e-licktronic/Nava-v1.0/Eagle/Nava_v1.02.brd

## EAGLE design Eagle/Nava_v1.02.brd (2022-08-23)

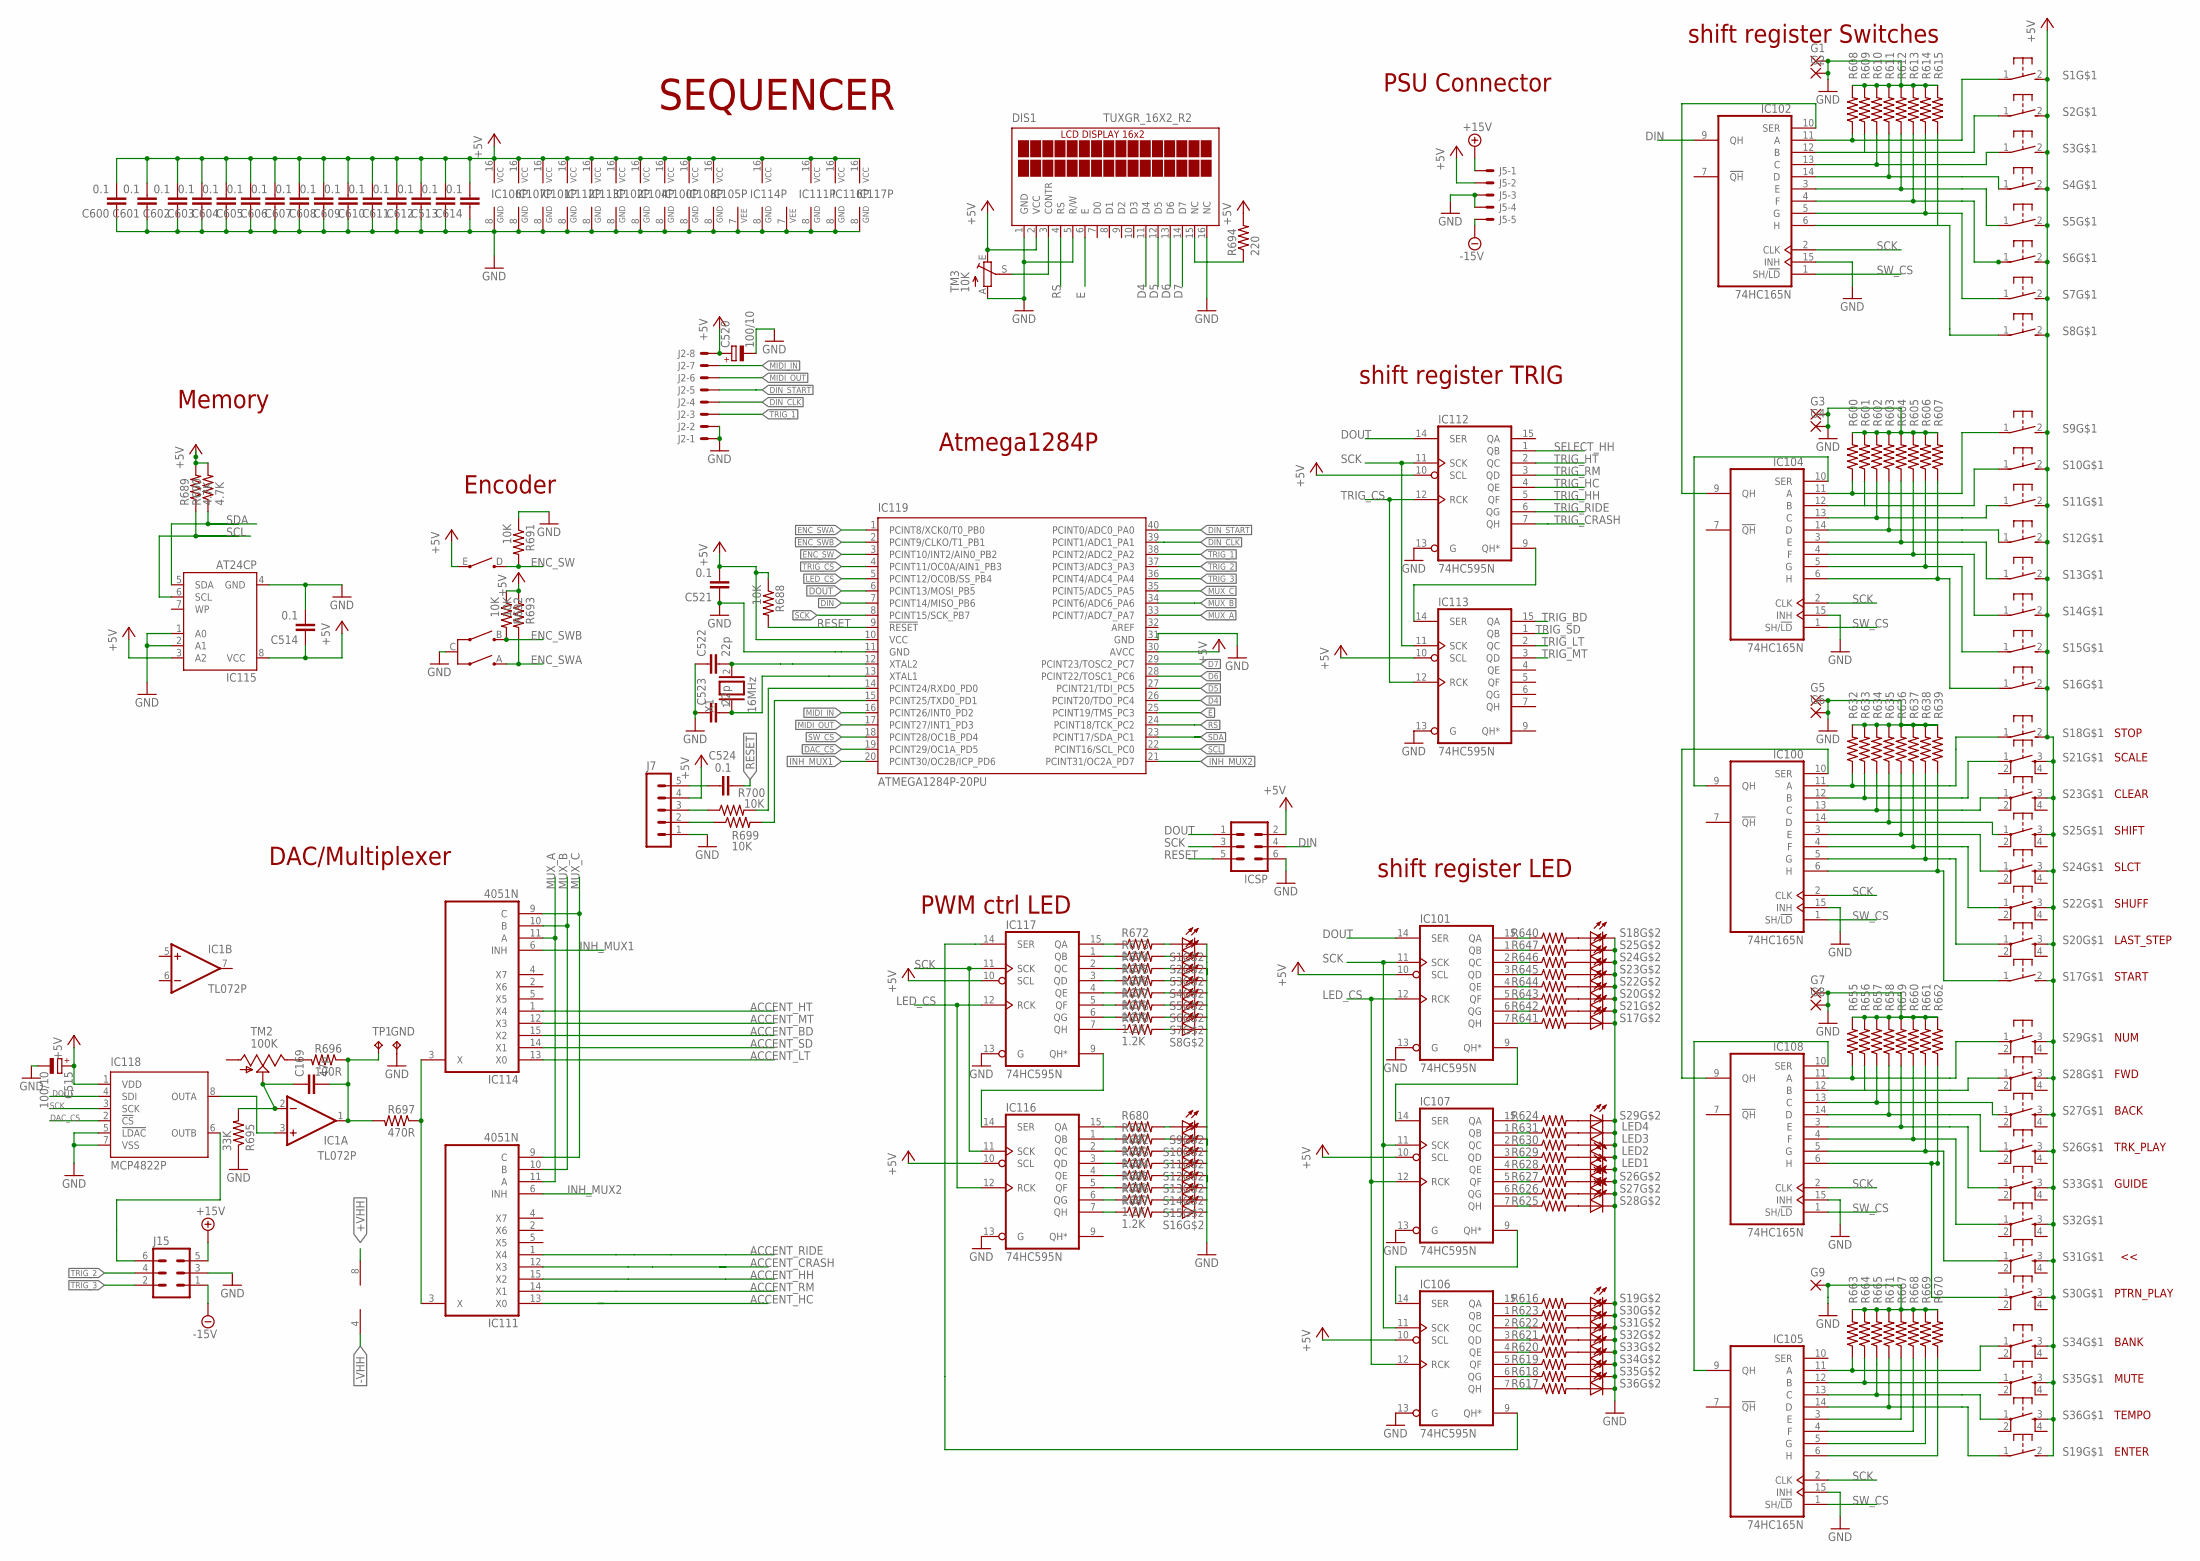
[picture p1: schematic Nava_v1.02.sch, sheet 1, SEQ]

Parts:
C169: 47p; C025-025X050
C513, C514, C521, C524, C600, C601, C602, C603, C604, C605, C606, C607, C608, C609, C610, C611, C612, C614: 0.1; C050-024X044
C515, C520: 100/10; E2-5
C522, C523: 22p; C025-025X050
DIS1: TUXGR_16X2_R2
G1, G2, G3, G4, G5, G6, G7, G8, G9: WIREPAD1,6/0,8; 1,6/0,8
GND: TPPAD1-13; P1-13
IC1: TL072P; DIL08
IC100, IC102, IC104, IC105, IC108: 74HC165N; DIL16
IC101, IC106, IC107, IC112, IC113, IC116, IC117: 74HC595N; DIL16
IC111, IC114: 4051N; DIL16
IC115: AT24CP; DIL08
IC118: MCP4822P; DIL8
IC119: ATMEGA1284P-20PU; DIL40
ICSP: MA03-2
J2: 22-27-2081-08; 6410-08
J5: KK-156-5
J7: MA05-1; MA05-1A
J15: MA03-2
LED1, LED2, LED3, LED4: LED3MM
R600, R601, R602, R603, R604, R605, R606, R607, R608, R609, R610, R611, R612, R613, R614, R615, R632, R633, R634, R635, R636, R637, R638, R639, R655, R656, R657, R658, R659, R660, R661, R662, R663, R664, R665, R667, R668, R669, R670, R671, R688, R691, R692, R693, R699, R700: 10K; 0207/7
R616, R617, R618, R619, R620, R621, R622, R623, R624, R625, R626, R627, R628, R629, R630, R631, R640, R641, R642, R643, R644, R645, R646, R647, R672, R673, R674, R675, R676, R677, R678, R679, R680, R681, R682, R683, R684, R685, R686, R687: 1.2K; 0207/7
R689, R690: 4.7K; 0207/7
R694: 220; 0207/7
R695: 33K; 0207/7
R696: 100R; 0207/7
R697: 470R; 0207/7
S1, S2, S3, S4, S5, S6, S7, S8, S9, S10, S11, S12, S13, S14, S15, S16, S17, S18, S19: MX1A_CHERRY_SW_LED"; MX1A-SW
S20, S21, S22, S23, S24, S25, S26, S27, S28, S29, S30, S31, S32, S33, S34, S35, S36: ZTSN_SW_LED"; SPH_SW
TM2: 100K; S64W
TM3: 10K; B25P
TP1: TPPAD1-13; P1-13
VR29: PEC16_ENCODER
X1: 16MHz; QS

Connections:
+5V: C513.2, C514.1, C515.+, C520.+, C521.2, C600.2, C601.2, C602.2, C603.2, C604.2, C605.2, C606.2, C607.2, C608.2, C609.2, C610.2, C611.2, C612.2, C614.2, DIS1.2 (VCC), IC100.16 (VCC), IC101.10 (SCL), IC101.16 (VCC), IC102.16 (VCC), IC104.16 (VCC), IC105.16 (VCC), IC106.10 (SCL), IC106.16 (VCC), IC107.10 (SCL), IC107.16 (VCC), IC108.16 (VCC), IC111.16 (VCC), IC112.10 (SCL), IC112.16 (VCC), IC113.10 (SCL), IC113.16 (VCC), IC114.16 (VCC), IC115.3 (A2), IC115.8 (VCC), IC116.10 (SCL), IC116.16 (VCC), IC117.10 (SCL), IC117.16 (VCC), IC118.1 (VDD), IC119.10 (VCC), IC119.30 (AVCC), ICSP.2, J2.8, J5.2, J7.4, R688.1, R689.2, R690.2, R692.1, R693.1, R694.2, S1.2 (S), S2.2 (S), S3.2 (S), S4.2 (S), S5.2 (S), S6.2 (S), S7.2 (S), S8.2 (S), S9.2 (S), S10.2 (S), S11.2 (S), S12.2 (S), S13.2 (S), S14.2 (S), S15.2 (S), S16.2 (S), S17.2 (S), S18.2 (S), S19.2 (S), S20.3 (S), S22.3 (S), S23.3 (S), S24.3 (S), S25.3 (S), S26.3 (S), S27.3 (S), S28.3 (S), S29.3 (S), S30.3 (S), S31.3 (S), S32.3 (S), S33.3 (S), S34.3 (S), S35.3 (S), S36.3 (S), TM3.E, VR29.E; also elsewhere on the board
+15V: J5.1, J15.5; also elsewhere on the board
+VHH: IC1.8 (V+); also elsewhere on the board
-15V: J5.5, J15.1; also elsewhere on the board
-VHH: IC1.4 (V-); also elsewhere on the board
ACCENT_BD: IC114.15 (X2); also elsewhere on the board
ACCENT_CRASH: IC111.12 (X3); also elsewhere on the board
ACCENT_HC: IC111.13 (X0); also elsewhere on the board
ACCENT_HH: IC111.15 (X2); also elsewhere on the board
ACCENT_HT: IC114.1 (X4); also elsewhere on the board
ACCENT_LT: IC114.13 (X0); also elsewhere on the board
ACCENT_MT: IC114.12 (X3); also elsewhere on the board
ACCENT_RIDE: IC111.1 (X4); also elsewhere on the board
ACCENT_RM: IC111.14 (X1); also elsewhere on the board
ACCENT_SD: IC114.14 (X1); also elsewhere on the board
D4: DIS1.11 (D4), IC119.26 (PCINT20/TDO_PC4)
D5: DIS1.12 (D5), IC119.27 (PCINT21/TDI_PC5)
D6: DIS1.13 (D6), IC119.28 (PCINT22/TOSC1_PC6)
D7: DIS1.14 (D7), IC119.29 (PCINT23/TOSC2_PC7)
DAC_CS: IC118.2 (!CS!), IC119.19 (PCINT29/OC1A_PD5)
DIN: IC102.9 (QH), IC119.7 (PCINT14/MISO_PB6), ICSP.4
DIN_CLK: IC119.39 (PCINT1/ADC1_PA1), J2.4
DIN_START: IC119.40 (PCINT0/ADC0_PA0), J2.5
DOUT: IC101.14 (SER), IC112.14 (SER), IC118.4 (SDI), IC119.6 (PCINT13/MOSI_PB5), ICSP.1
E: DIS1.6 (E), IC119.25 (PCINT19/TMS_PC3)
ENC_SW: IC119.3 (PCINT10/INT2/AIN0_PB2), R691.2, VR29.D
ENC_SWA: IC119.1 (PCINT8/XCK0/T0_PB0), R693.2, VR29.A
ENC_SWB: IC119.2 (PCINT9/CLKO/T1_PB1), R692.2, VR29.B
GND: C513.1, C514.2, C515.-, C520.-, C521.1, C522.1, C523.1, C600.1, C601.1, C602.1, C603.1, C604.1, C605.1, C606.1, C607.1, C608.1, C609.1, C610.1, C611.1, C612.1, C614.1, DIS1.1 (GND), DIS1.5 (R/W), DIS1.16 (NC), G1.1, G2.1, G3.1, G4.1, G5.1, G6.1, G7.1, G8.1, G9.1, GND.TP, IC100.8 (GND), IC100.15 (INH), IC101.8 (GND), IC101.13 (G), IC102.8 (GND), IC102.15 (INH), IC104.8 (GND), IC104.15 (INH), IC105.8 (GND), IC105.15 (INH), IC106.8 (GND), IC106.13 (G), IC107.8 (GND), IC107.13 (G), IC108.8 (GND), IC108.15 (INH), IC111.7 (VEE), IC111.8 (GND), IC112.8 (GND), IC112.13 (G), IC113.8 (GND), IC113.13 (G), IC114.7 (VEE), IC114.8 (GND), IC115.1 (A0), IC115.2 (A1), IC115.4 (GND), IC116.8 (GND), IC116.13 (G), IC117.8 (GND), IC117.13 (G), IC118.5 (!LDAC!), IC118.7 (VSS), IC119.11 (GND), IC119.31 (GND), ICSP.6, J2.1, J2.2, J5.3, J5.4, J7.1, J15.3, LED1.K (C), LED2.K (C), LED3.K (C), LED4.K (C), R600.2, R601.2, R602.2, R603.2, R604.2, R605.2, R606.2, R607.2, R608.2, R609.2, R610.2, R611.2, R612.2, R613.2, R614.2, R615.2, R632.2, R633.2, R634.2, R635.2, R636.2, R637.2, R638.2, R639.2, R655.2, R656.2, R657.2, R658.2, R659.2, R660.2, R661.2, R662.2, R663.2, R664.2, R665.2, R667.2, R668.2, R669.2, R670.2, R671.2, R691.1, R695.1, S1.K (C), S2.K (C), S3.K (C), S4.K (C), S5.K (C), S6.K (C), S7.K (C), S8.K (C), S9.K (C), S10.K (C), S11.K (C), S12.K (C), S13.K (C), S14.K (C), S15.K (C), S16.K (C), S17.K (C), S18.K (C), S19.K (C), S20.K (C), S21.K (C), S22.K (C), S23.K (C), S24.K (C), S25.K (C), S26.K (C), S27.K (C), S28.K (C), S29.K (C), S30.K (C), S31.K (C), S32.K (C), S33.K (C), S34.K (C), S35.K (C), S36.K (C), TM3.A, VR29.C; also elsewhere on the board
INH_MUX1: IC114.6 (INH), IC119.20 (PCINT30/OC2B/ICP_PD6)
INH_MUX2: IC111.6 (INH), IC119.21 (PCINT31/OC2A_PD7)
LED_CS: IC101.12 (RCK), IC106.12 (RCK), IC107.12 (RCK), IC116.12 (RCK), IC117.12 (RCK), IC119.5 (PCINT12/OC0B/SS_PB4)
MIDI_IN: IC119.16 (PCINT26/INT0_PD2), J2.7
MIDI_OUT: IC119.17 (PCINT27/INT1_PD3), J2.6
MUX_A: IC111.11 (A), IC114.11 (A), IC119.33 (PCINT7/ADC7_PA7)
MUX_B: IC111.10 (B), IC114.10 (B), IC119.34 (PCINT6/ADC6_PA6)
MUX_C: IC111.9 (C), IC114.9 (C), IC119.35 (PCINT5/ADC5_PA5)
unnamed: R624.2, S29.A
unnamed: R625.2, S28.A
unnamed: R626.2, S27.A
unnamed: R627.2, S26.A
unnamed: R647.2, S25.A
unnamed: R646.2, S24.A
unnamed: R645.2, S23.A
unnamed: R644.2, S22.A
unnamed: R642.2, S21.A
unnamed: R643.2, S20.A
unnamed: R640.2, S18.A
unnamed: R641.2, S17.A
unnamed: LED4.A, R631.2
unnamed: LED3.A, R630.2
unnamed: LED2.A, R629.2
unnamed: LED1.A, R628.2
unnamed: R616.2, S19.A
unnamed: R617.2, S36.A
unnamed: R618.2, S35.A
unnamed: R619.2, S34.A
unnamed: R620.2, S33.A
unnamed: R621.2, S32.A
unnamed: R622.2, S31.A
unnamed: R623.2, S30.A
unnamed: IC108.14 (D), R658.1, S26.1
unnamed: IC1.3 (+IN), IC118.8 (OUTA)
unnamed: IC117.15 (QA), R672.1
unnamed: IC117.1 (QB), R673.1
unnamed: IC117.2 (QC), R674.1
unnamed: IC117.3 (QD), R675.1
unnamed: IC117.4 (QE), R676.1
unnamed: IC117.5 (QF), R677.1
unnamed: IC117.6 (QG), R678.1
unnamed: IC117.7 (QH), R679.1
unnamed: IC116.14 (SER), IC117.9 (QH*)
unnamed: IC116.15 (QA), R680.1
unnamed: IC116.1 (QB), R681.1
unnamed: IC116.2 (QC), R682.1
unnamed: IC116.3 (QD), R683.1
unnamed: IC116.4 (QE), R684.1
unnamed: IC116.5 (QF), R685.1
unnamed: IC116.6 (QG), R686.1
unnamed: IC116.7 (QH), R687.1
unnamed: R680.2, S9.A
unnamed: R681.2, S10.A
unnamed: R682.2, S11.A
unnamed: R683.2, S12.A
unnamed: R684.2, S13.A
unnamed: R685.2, S14.A
unnamed: R686.2, S15.A
unnamed: R687.2, S16.A
unnamed: R672.2, S1.A
unnamed: R673.2, S2.A
unnamed: R674.2, S3.A
unnamed: R675.2, S4.A
unnamed: R676.2, S5.A
unnamed: R677.2, S6.A
unnamed: R678.2, S7.A
unnamed: R679.2, S8.A
unnamed: IC106.9 (QH*), IC117.14 (SER)
unnamed: IC118.6 (OUTB), J15.6
unnamed: IC119.15 (PCINT25/TXD0_PD1), R699.2
unnamed: IC119.14 (PCINT24/RXD0_PD0), R700.2
unnamed: C522.2, IC119.12 (XTAL2), X1.2
unnamed: C523.2, IC119.13 (XTAL1), X1.1
unnamed: IC102.11 (A), R608.1, S1.1
unnamed: IC102.12 (B), R609.1, S2.1
unnamed: IC102.13 (C), R610.1, S3.1
unnamed: IC102.14 (D), R611.1, S4.1
unnamed: IC102.3 (E), R612.1, S5.1
unnamed: IC102.4 (F), R613.1, S6.1
unnamed: IC102.5 (G), R614.1, S7.1
unnamed: IC102.6 (H), R615.1, S8.1
unnamed: IC104.11 (A), R600.1, S9.1
unnamed: IC104.12 (B), R601.1, S10.1
unnamed: IC104.13 (C), R602.1, S11.1
unnamed: IC104.14 (D), R603.1, S12.1
unnamed: IC104.3 (E), R604.1, S13.1
unnamed: IC104.4 (F), R605.1, S14.1
unnamed: IC104.5 (G), R606.1, S15.1
unnamed: IC104.6 (H), R607.1, S16.1
unnamed: IC100.11 (A), R632.1, S18.1
unnamed: IC100.12 (B), R633.1, S21.1
unnamed: IC100.13 (C), R634.1, S23.1
unnamed: IC100.14 (D), R635.1, S25.1
unnamed: IC100.3 (E), R636.1, S24.1
unnamed: IC100.4 (F), R637.1, S22.1
unnamed: IC100.5 (G), R638.1, S20.1
unnamed: IC102.10 (SER), IC104.9 (QH)
unnamed: IC100.9 (QH), IC104.10 (SER)
unnamed: IC100.6 (H), R639.1, S17.1
unnamed: IC111.3 (X), IC114.3 (X), R697.1
unnamed: IC101.15 (QA), R640.1
unnamed: IC100.10 (SER), IC108.9 (QH)
unnamed: IC108.11 (A), R655.1, S29.1
unnamed: IC108.12 (B), R656.1, S28.1
unnamed: IC108.13 (C), R657.1, S27.1
unnamed: IC108.3 (E), R659.1, S33.1
unnamed: IC108.4 (F), R660.1, S32.1
unnamed: IC108.5 (G), R661.1, S31.1
unnamed: IC108.6 (H), R662.1, S30.1
unnamed: IC101.1 (QB), R647.1
unnamed: IC105.9 (QH), IC108.10 (SER)
unnamed: IC101.2 (QC), R646.1
unnamed: IC105.11 (A), R663.1, S34.1
unnamed: IC105.12 (B), R664.1, S35.1
unnamed: IC105.13 (C), R665.1, S36.1
unnamed: IC105.14 (D), R671.1, S19.1
unnamed: IC105.3 (E), R667.1
unnamed: IC105.4 (F), R668.1
unnamed: IC105.5 (G), R669.1
unnamed: IC105.6 (H), R670.1
unnamed: IC101.3 (QD), R645.1
unnamed: IC101.4 (QE), R644.1
unnamed: IC101.5 (QF), R643.1
unnamed: IC101.6 (QG), R642.1
unnamed: IC101.7 (QH), R641.1
unnamed: IC107.15 (QA), R624.1
unnamed: IC107.1 (QB), R631.1
unnamed: IC107.2 (QC), R630.1
unnamed: IC107.3 (QD), R629.1
unnamed: IC107.4 (QE), R628.1
unnamed: IC107.5 (QF), R627.1
unnamed: IC107.6 (QG), R626.1
unnamed: IC107.7 (QH), R625.1
unnamed: IC101.9 (QH*), IC107.14 (SER)
unnamed: IC106.14 (SER), IC107.9 (QH*)
unnamed: IC106.15 (QA), R616.1
unnamed: IC106.1 (QB), R623.1
unnamed: IC106.2 (QC), R622.1
unnamed: IC106.3 (QD), R621.1
unnamed: IC106.4 (QE), R620.1
unnamed: IC106.5 (QF), R619.1
unnamed: IC106.6 (QG), R618.1
unnamed: IC106.7 (QH), R617.1
unnamed: R696.2, TM2.E
unnamed: C169.2, IC1.1 (OUT), R696.1, R697.2, TP1.TP
unnamed: C169.1, IC1.2 (-IN), R695.2, TM2.S
unnamed: DIS1.15 (NC), R694.1
unnamed: DIS1.3 (CONTR), TM3.S
unnamed: IC112.9 (QH*), IC113.14 (SER)
unnamed: C524.2, J7.5
unnamed: J7.3, R700.1
unnamed: J7.2, R699.1
RESET: C524.1, IC119.9 (!RESET), ICSP.5, R688.2
RS: DIS1.4 (RS), IC119.24 (PCINT18/TCK_PC2)
SCK: IC100.2 (CLK), IC101.11 (SCK), IC102.2 (CLK), IC104.2 (CLK), IC105.2 (CLK), IC106.11 (SCK), IC107.11 (SCK), IC108.2 (CLK), IC112.11 (SCK), IC113.11 (SCK), IC116.11 (SCK), IC117.11 (SCK), IC118.3 (SCK), IC119.8 (PCINT15/SCK_PB7), ICSP.3
SCL: IC115.6 (SCL), IC119.22 (PCINT16/SCL_PC0), R689.1
SDA: IC115.5 (SDA), IC119.23 (PCINT17/SDA_PC1), R690.1
SELECT_HH: IC112.1 (QB); also elsewhere on the board
SW_CS: IC100.1 (SH/!LD), IC102.1 (SH/!LD), IC104.1 (SH/!LD), IC105.1 (SH/!LD), IC108.1 (SH/!LD), IC119.18 (PCINT28/OC1B_PD4)
TRIG_1: IC119.38 (PCINT2/ADC2_PA2), J2.3
TRIG_2: IC119.37 (PCINT3/ADC3_PA3), J15.4
TRIG_3: IC119.36 (PCINT4/ADC4_PA4), J15.2
TRIG_BD: IC113.15 (QA); also elsewhere on the board
TRIG_CRASH: IC112.7 (QH); also elsewhere on the board
TRIG_CS: IC112.12 (RCK), IC113.12 (RCK), IC119.4 (PCINT11/OC0A/AIN1_PB3)
TRIG_HC: IC112.4 (QE); also elsewhere on the board
TRIG_HH: IC112.5 (QF); also elsewhere on the board
TRIG_HT: IC112.2 (QC); also elsewhere on the board
TRIG_LT: IC113.2 (QC); also elsewhere on the board
TRIG_MT: IC113.3 (QD); also elsewhere on the board
TRIG_RIDE: IC112.6 (QG); also elsewhere on the board
TRIG_RM: IC112.3 (QD); also elsewhere on the board
TRIG_SD: IC113.1 (QB); also elsewhere on the board

Notes on the sheet:
Memory
Encoder
Atmega1284P
DAC/Multiplexer
PWM ctrl LED
shift register LED
shift register TRIG
shift register Switches
SEQUENCER
PSU Connector
STOP
SCALE
CLEAR
SHIFT
SLCT
SHUFF
LAST_STEP
START
NUM
FWD
BACK
TRK_PLAY
GUIDE
PTRN_PLAY
BANK
MUTE
TEMPO
ENTER

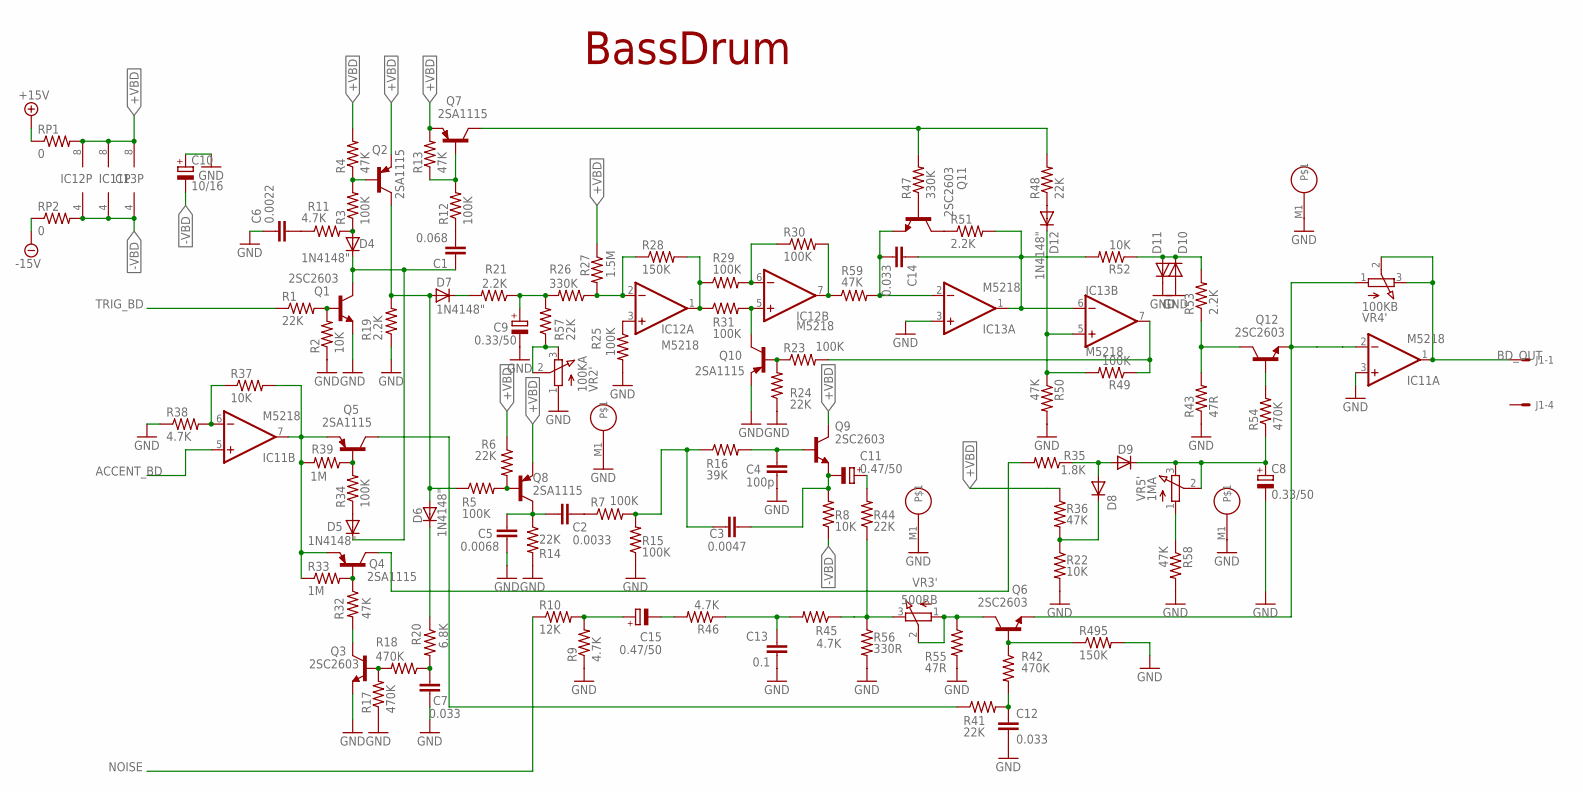
[picture p2: schematic Nava_v1.02.sch, sheet 2, BD]

Parts:
C1: 0.068; C050-025X075
C2: 0.0033; C050-025X075
C3: 0.0047; C050-025X075
C4: 100p; C050-025X075
C5: 0.0068; C050-025X075
C6: 0.0022; C050-025X075
C7, C12, C14: 0.033; C050-025X075
C8, C9: 0.33/50; E2-5
C10: 10/16; E2-5
C11, C15: 0.47/50; E2-5
C13: 0.1; C050-025X075
D4, D5, D6, D7, D8, D9, D10, D11, D12: 1N4148"; DO35-7C
IC11, IC12, IC13: M5218; SIL8
J1: 22-27-2041-04; 6410-04
Q1, Q3, Q6, Q9, Q11, Q12: 2SC2603; TO92-ECB
Q2, Q4, Q5, Q7, Q8, Q10: 2SA1115; TO92-ECB-PNP
R1, R6, R14, R24, R41, R44, R48, R57: 22K; 0207/7
R2, R8, R22, R37, R52: 10K; 0207/7
R3, R5, R7, R12, R15, R23, R25, R29, R30, R31, R34, R49: 100K; 0207/7
R4, R13, R32, R36, R50, R58, R59: 47K; 0207/7
R9, R11, R38, R45, R46: 4.7K; 0207/7
R10: 12K; 0207/7
R16: 39K; 0207/7
R17, R18, R42, R54: 470K; 0207/7
R19, R21, R51, R53: 2.2K; 0207/7
R20: 6.8K; 0207/7
R26, R47: 330K; 0207/7
R27: 1.5M; 0207/7
R28, R495: 150K; 0207/7
R33, R39: 1M; 0207/7
R35: 1.8K; 0207/7
R43, R55: 47R; 0207/7
R56: 330R; 0207/7
RP1, RP2: 0; 0207/7
VR2: 100KA; EVUF
VR3: 500RB; EVUF
VR4: 100KB; EVUF
VR5: 1MA; EVUF

Connections:
+15V: RP1.1; also elsewhere on the board
+VBD: IC11.8 (V+), IC12.8 (V+), IC13.8 (V+), Q2.E, Q7.E, Q8.E, Q9.C, R4.2, R6.1, R13.2, R27.1, R36.1, RP1.2
-15V: RP2.1; also elsewhere on the board
-VBD: C10.-, IC11.4 (V-), IC12.4 (V-), IC13.4 (V-), R8.1, RP2.2
ACCENT_BD: IC11.5 (+IN); also elsewhere on the board
BD_OUT: IC11.1 (OUT), J1.1, VR4.2 (S), VR4.3 (E)
GND: C4.2, C5.1, C6.1, C7.1, C8.-, C9.-, C10.+, C12.2, C13.2, D10.A, D11.C, IC11.3 (+IN), IC13.3 (+IN), Q1.E, Q3.E, Q10.E, R2.1, R9.1, R14.2, R15.1, R17.1, R19.1, R22.2, R24.1, R25.2, R38.1, R43.1, R50.2, R55.2, R56.2, R58.2, R495.2, VR2.1 (A), VR2.M1, VR3.M1, VR4.M1, VR5.M1; also elsewhere on the board
unnamed: Q1.B, R1.2, R2.2
unnamed: Q2.B, R3.2, R4.1
unnamed: Q5.B, R34.2, R39.1
unnamed: Q4.B, R32.1, R33.2
unnamed: Q3.B, R17.2, R18.2
unnamed: C7.2, R18.1, R20.2
unnamed: C2.2, C5.2, Q8.C, R14.1
unnamed: Q8.B, R5.2, R6.2
unnamed: D4.A, R3.1, R11.2
unnamed: D5.A, R34.1
unnamed: D6.A, D7.A, Q2.C, R5.1, R19.2
unnamed: C1.1, D4.C, D5.C, Q1.C
unnamed: Q7.B, R12.2, R13.1
unnamed: Q3.C, R32.2
unnamed: C6.2, R11.1
unnamed: C1.2, R12.1
unnamed: D6.C, R20.1
unnamed: D7.C, R21.2
unnamed: C9.+, R21.1, R26.2, R57.2
unnamed: R57.1, VR2.2 (S), VR2.3 (E)
unnamed: IC12.2 (-IN), R26.1, R27.2, R28.1
unnamed: IC11.7 (OUT), Q4.E, Q5.E, R33.1, R37.2, R39.2
unnamed: IC11.6 (-IN), R37.1, R38.2
unnamed: IC12.3 (+IN), R25.1
unnamed: IC12.1 (OUT), R28.2, R29.1, R31.1
unnamed: IC12.5 (+IN), Q10.C, R31.2
unnamed: IC12.6 (-IN), R29.2, R30.1
unnamed: IC12.7 (OUT), R30.2, R59.1
unnamed: Q10.B, R23.1, R24.2
unnamed: Q11.B, R47.1
unnamed: Q7.C, R47.2, R48.2
unnamed: C14.2, IC13.2 (-IN), Q11.E, R59.2
unnamed: Q11.C, R51.1
unnamed: D12.A, R48.1
unnamed: C14.1, IC13.1 (OUT), IC13.6 (-IN), R51.2, R52.2
unnamed: IC13.7 (OUT), R23.2, R49.1
unnamed: D12.C, IC13.5 (+IN), R49.2, R50.1
unnamed: D10.C, D11.A, R52.1, R53.2
unnamed: Q12.B, R54.2
unnamed: Q12.C, R43.2, R53.1
unnamed: C8.+, D9.C, R54.1, VR5.2 (S), VR5.3 (E)
unnamed: D8.C, R22.1, R36.2
unnamed: D8.A, D9.A, R35.1
unnamed: R58.1, VR5.1 (A)
unnamed: Q4.C, R35.2
unnamed: C2.1, R7.1
unnamed: C3.1, R7.2, R15.2, R16.1
unnamed: C4.1, Q9.B, R16.2
unnamed: C3.2, C11.-, Q9.E, R8.2
unnamed: C11.+, R44.2
unnamed: C15.+, R9.2, R10.2
unnamed: Q6.B, R42.1, R495.1
unnamed: C12.1, R41.2, R42.2
unnamed: C15.-, R46.2
unnamed: C13.1, R45.2, R46.1
unnamed: R44.1, R45.1, R56.1, VR3.3 (E)
unnamed: Q6.C, R55.1, VR3.1 (A), VR3.2 (S)
unnamed: Q5.C, R41.1
unnamed: IC11.2 (-IN), Q6.E, Q12.E, VR4.1 (A)
NOISE: R10.1; also elsewhere on the board
TRIG_BD: R1.1; also elsewhere on the board

Notes on the sheet:
BassDrum

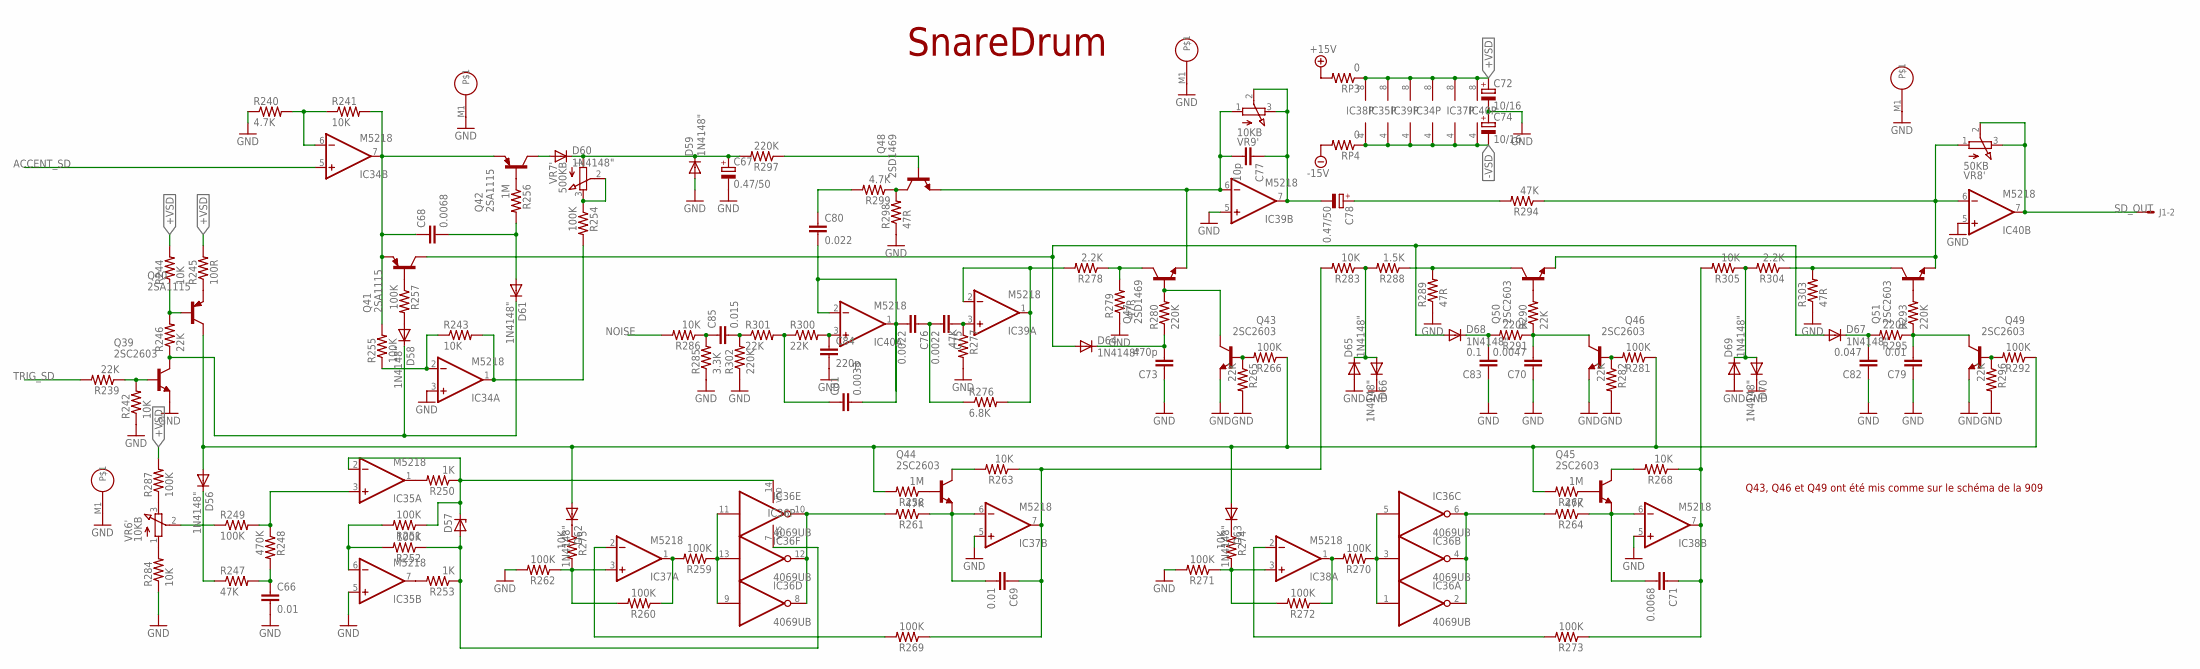
[picture p3: schematic Nava_v1.02.sch, sheet 3, SD]

Parts:
C66, C69, C79: 0.01; C050-025X075
C67, C78: 0.47/50; E2-5
C68, C71: 0.0068; C050-025X075
C70: 0.0047; C050-025X075
C72, C74: 10/16; E2-5
C73: 470p; C050-025X075
C75, C76: 0.0022; C050-025X075
C77: 10p; C050-025X075
C80: 0.022; C050-025X075
C81: 0.0033; C050-025X075
C82: 0.047; C050-025X075
C83: 0.1; C050-025X075
C84: 220p; C050-025X075
C85: 0.015; C050-025X075
D56, D58, D59, D60, D61, D62, D63, D64, D65, D66, D67, D68, D69, D70: 1N4148"; DO35-7C
D57: ZENER-DIODE; DO41-7
IC34, IC35, IC37, IC38, IC39, IC40: M5218; SIL8
IC36: 4069UB; DIL14
J1: 22-27-2041-04; 6410-04
Q39, Q43, Q44, Q45, Q46, Q49, Q50, Q51: 2SC2603; TO92-ECB
Q40, Q41, Q42: 2SA1115; TO92-ECB-PNP
Q47, Q48: 2SD1469; TO-3
R239, R246, R265, R282, R290, R296, R300, R301: 22K; 0207/7
R240, R299: 4.7K; 0207/7
R241, R242, R243, R244, R263, R268, R274, R275, R283, R284, R286, R305: 10K; 0207/7
R245: 100R; 0207/7
R247, R261, R264, R277, R294: 47K; 0207/7
R248: 470K; 0207/7
R249, R251, R252, R254, R255, R257, R259, R260, R262, R266, R269, R270, R271, R272, R273, R281, R287, R292: 100K; 0207/7
R250, R253: 1K; 0207/7
R256, R258, R267: 1M; 0207/7
R276: 6.8K; 0207/7
R278, R304: 2.2K; 0207/7
R279, R289, R298, R303: 47R; 0207/7
R280, R291, R293, R295, R297, R302: 220K; 0207/7
R285: 3.3K; 0207/7
R288: 1.5K; 0207/7
RP3, RP4: 0; 0207/7
VR6, VR9: 10KB; EVUF
VR7: 500KB; EVUF
VR8: 50KB; EVUF

Connections:
+15V: RP3.2; also elsewhere on the board
+VSD: C72.+, IC34.8 (V+), IC35.8 (V+), IC37.8 (V+), IC38.8 (V+), IC39.8 (V+), IC40.8 (V+), R244.2, R245.2, R287.2, RP3.1
-15V: RP4.2; also elsewhere on the board
-VSD: C74.-, IC34.4 (V-), IC35.4 (V-), IC37.4 (V-), IC38.4 (V-), IC39.4 (V-), IC40.4 (V-), RP4.1
ACCENT_SD: IC34.5 (+IN); also elsewhere on the board
GND: C66.2, C67.-, C70.1, C72.-, C73.1, C74.+, C79.1, C82.1, C83.1, C84.2, D59.A, D65.A, D66.C, D69.A, D70.C, IC34.3 (+IN), IC35.5 (+IN), IC37.5 (+IN), IC38.5 (+IN), IC39.5 (+IN), IC40.5 (+IN), Q39.E, Q43.E, Q46.E, Q49.E, R240.1, R242.1, R262.2, R265.2, R271.2, R277.2, R279.1, R282.2, R284.1, R285.1, R289.1, R296.2, R298.1, R302.1, R303.1, VR6.M1, VR7.M1, VR8.M1, VR9.M1; also elsewhere on the board
unnamed: Q50.B, R290.2
unnamed: Q46.B, R281.2, R282.1
unnamed: C70.2, Q46.C, R290.1, R291.1
unnamed: Q43.C, Q47.B, R280.2
unnamed: Q43.B, R265.1, R266.2
unnamed: C73.2, D64.C, R280.1
unnamed: C83.2, D68.C, R291.2
unnamed: D65.C, D66.A, R283.1, R288.2
unnamed: Q50.C, R288.1, R289.2
unnamed: Q51.B, R293.2
unnamed: Q49.B, R292.2, R296.1
unnamed: C79.2, Q49.C, R293.1, R295.1
unnamed: C82.2, D67.C, R295.2
unnamed: D69.C, D70.A, R304.2, R305.1
unnamed: Q51.C, R303.2, R304.1
unnamed: IC40.6 (-IN), Q50.E, Q51.E, R294.1, VR8.1 (A)
unnamed: Q45.B, R267.1
unnamed: C71.1, IC38.7 (OUT), R268.1, R273.1, R305.2
unnamed: C71.2, IC38.6 (-IN), Q45.E, R264.1
unnamed: Q45.C, R268.2
unnamed: IC36.2 (O), IC36.4 (O), IC36.6 (O), R264.2
unnamed: IC36.1 (I), IC36.3 (I), IC36.5 (I), R270.1
unnamed: IC38.1 (OUT), R270.2, R272.1
unnamed: IC38.3 (+IN), R271.1, R272.2, R274.2
unnamed: IC38.2 (-IN), R273.2
unnamed: D63.C, R274.1
unnamed: Q44.B, R258.1
unnamed: C69.2, IC37.6 (-IN), Q44.E, R261.1
unnamed: Q44.C, R263.2
unnamed: IC36.8 (O), IC36.10 (O), IC36.12 (O), R261.2
unnamed: IC36.9 (I), IC36.11 (I), IC36.13 (I), R259.1
unnamed: IC37.1 (OUT), R259.2, R260.1
unnamed: IC37.3 (+IN), R260.2, R262.1, R275.2
unnamed: IC37.2 (-IN), R269.2
unnamed: D62.C, R275.1
unnamed: D56.A, D62.A, D63.A, Q40.C, R258.2, R266.1, R267.2, R281.1, R292.1
unnamed: IC35.1 (OUT), R250.2
unnamed: IC35.7 (OUT), R253.2
unnamed: IC35.6 (-IN), R251.2, R252.2
unnamed: D57.A, IC36.7 (VSS), R252.1, R253.1
unnamed: D57.C, IC35.2 (-IN), IC36.14 (VDD), R250.1, R251.1
unnamed: R287.1, VR6.3 (E)
unnamed: R284.2, VR6.1 (A)
unnamed: R249.1, VR6.2 (S)
unnamed: IC35.3 (+IN), R248.1, R249.2
unnamed: C66.1, R247.2, R248.2
unnamed: D56.C, R247.1
unnamed: Q47.C, R278.1, R279.2
unnamed: C77.2, IC39.6 (-IN), Q47.E, Q48.E, VR9.1 (A)
unnamed: C77.1, C78.-, IC39.7 (OUT), VR9.2 (S), VR9.3 (E)
unnamed: C78.+, R294.2
unnamed: IC39.1 (OUT), IC39.2 (-IN), R276.2, R278.2
unnamed: D64.A, D67.A, D68.A, Q41.C
unnamed: C75.1, IC39.3 (+IN), R277.1
unnamed: C75.2, C76.1, R276.1
unnamed: C76.2, C80.2, C81.2, IC40.1 (OUT), IC40.2 (-IN)
unnamed: C84.1, IC40.3 (+IN), R300.2
unnamed: C81.1, R300.1, R301.2
unnamed: C85.2, R301.1, R302.2
unnamed: C85.1, R285.2, R286.1
unnamed: Q48.C, R298.2, R299.1
unnamed: C80.1, R299.2
unnamed: C67.+, D59.C, D60.C, R297.2, VR7.1 (A)
unnamed: R254.1, VR7.2 (S), VR7.3 (E)
unnamed: D60.A, Q42.C
unnamed: Q42.B, R256.1
unnamed: Q41.B, R257.1
unnamed: Q48.B, R297.1
unnamed: D58.A, R257.2
unnamed: IC34.6 (-IN), R240.2, R241.1
unnamed: C68.1, IC34.7 (OUT), Q41.E, Q42.E, R241.2, R255.2
unnamed: IC34.2 (-IN), R243.1, R255.1
unnamed: IC34.1 (OUT), R243.2, R254.2
unnamed: C68.2, D61.A, R256.2
unnamed: D58.C, D61.C, Q39.C, R246.1
unnamed: Q40.E, R245.1
unnamed: Q40.B, R244.1, R246.2
unnamed: Q39.B, R239.1, R242.2
NOISE: R286.2; also elsewhere on the board
R263: C69.1, IC37.7 (OUT), R263.1, R269.1, R283.2
SD_OUT: IC40.7 (OUT), J1.2, VR8.2 (S), VR8.3 (E)
TRIG_SD: R239.2; also elsewhere on the board

Notes on the sheet:
SnareDrum
Q43, Q46 et Q49 ont été mis comme sur le schéma de la 909
