e-licktronic/Nava-v1.0/Eagle/Nava_v1.02.brd

## EAGLE design Eagle/Nava_v1.02.brd (continued)

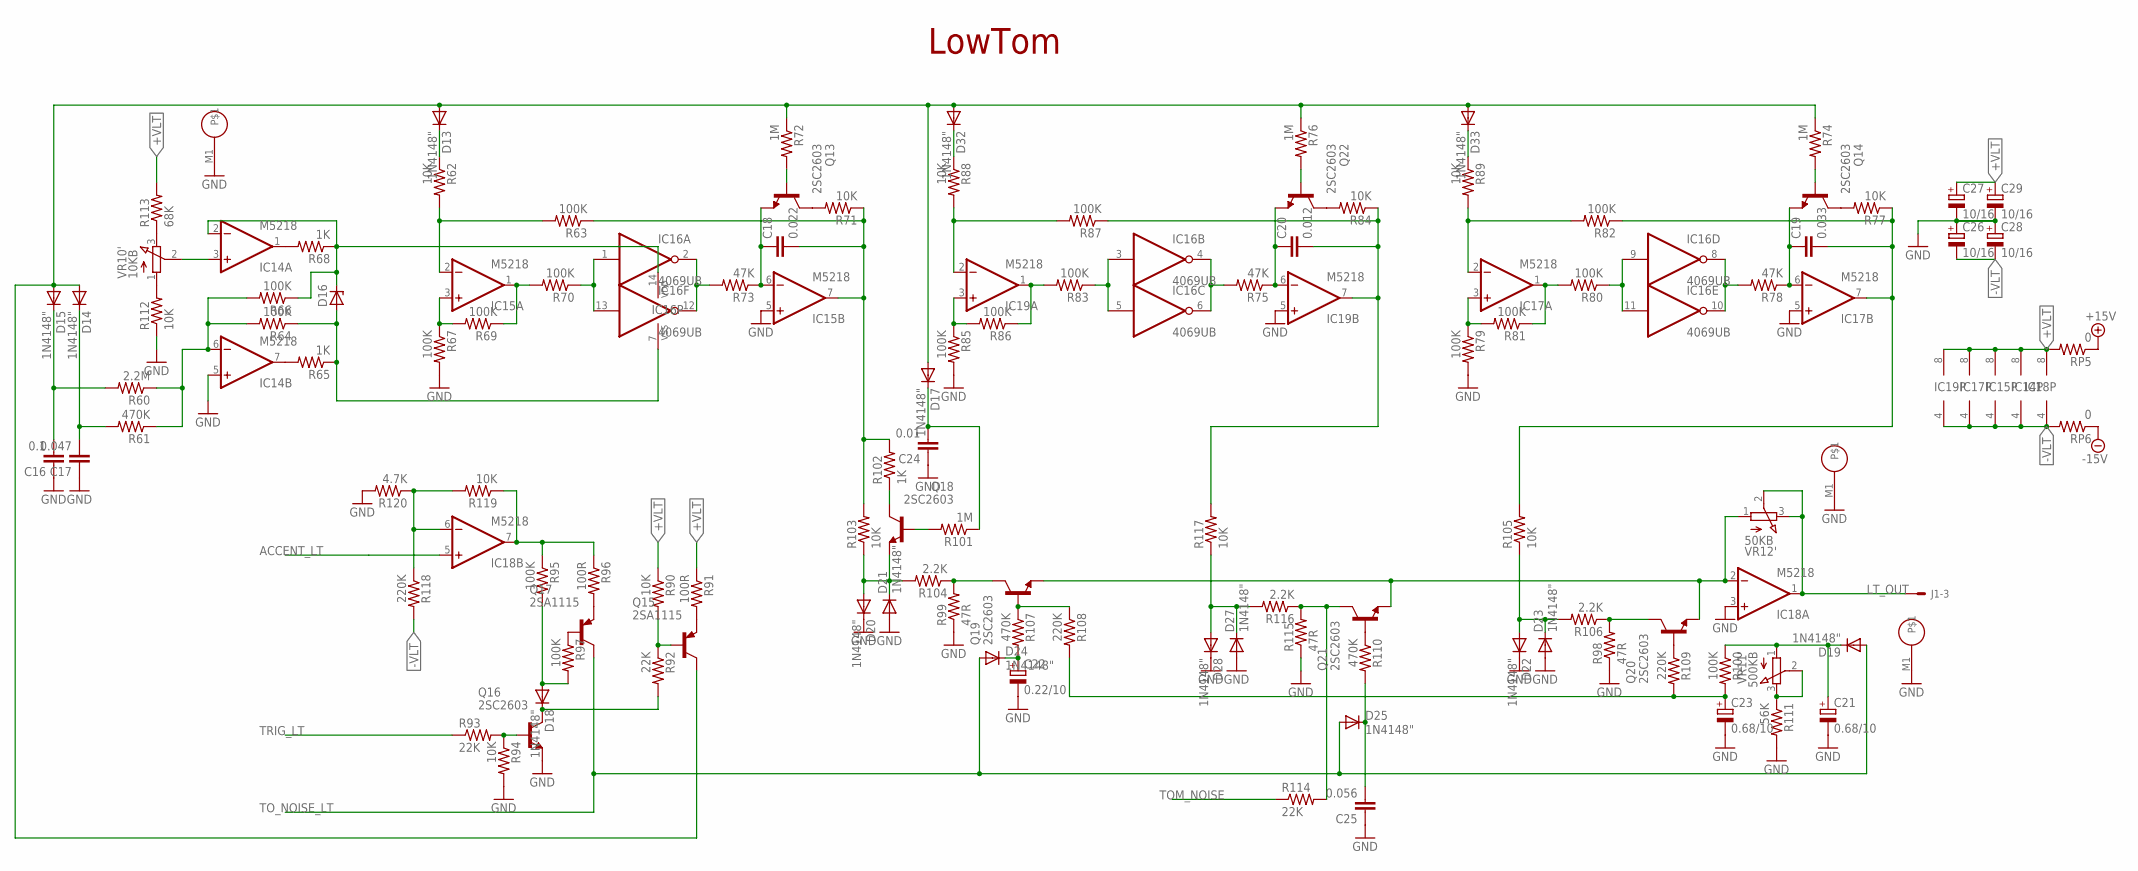
[picture p4: schematic Nava_v1.02.sch, sheet 4, LT]

Parts:
C16: 0.1; C050-025X075
C17: 0.047; C050-025X075
C18: 0.022; C050-025X075
C19: 0.033; C050-025X075
C20: 0.012; C050-025X075
C21, C23: 0.68/10; E2-5
C22: 0.22/10; E2-5
C24: 0.01; C050-025X075
C25: 0.056; C050-025X075
C26, C27, C28, C29: 10/16; E2-5
D13, D14, D15, D17, D18, D19, D20, D21, D22, D23, D24, D25, D27, D28, D32, D33: 1N4148"; DO35-7C
D16: ZENER-DIODE; DO41-7
IC14, IC15, IC17, IC18, IC19: M5218; SIL8
IC16: 4069UB; DIL14
J1: 22-27-2041-04; 6410-04
Q13, Q14, Q16, Q18, Q19, Q20, Q21, Q22: 2SC2603; TO92-ECB
Q15, Q17: 2SA1115; TO92-ECB-PNP
R60: 2.2M; 0207/7
R61, R107, R110: 470K; 0207/7
R62, R71, R77, R84, R88, R89, R90, R94, R103, R105, R112, R117, R119: 10K; 0207/7
R63, R64, R66, R67, R69, R70, R79, R80, R81, R82, R83, R85, R86, R87, R95, R97, R100: 100K; 0207/7
R65, R68, R102: 1K; 0207/7
R72, R74, R76, R101: 1M; 0207/7
R73, R75, R78: 47K; 0207/7
R91, R96: 100R; 0207/7
R92, R93, R114: 22K; 0207/7
R98, R99, R115: 47R; 0207/7
R104, R106, R116: 2.2K; 0207/7
R108, R109, R118: 220K; 0207/7
R111: 56K; 0207/7
R113: 68K; 0207/7
R120: 4.7K; 0207/7
RP5, RP6: 0; 0207/7
VR10: 10KB; EVUF
VR11: 500KB; EVUF
VR12: 50KB; EVUF

Connections:
+15V: RP5.1; also elsewhere on the board
+VLT: C27.+, C29.+, IC14.8 (V+), IC15.8 (V+), IC17.8 (V+), IC18.8 (V+), IC19.8 (V+), R90.1, R91.1, R113.2, RP5.2
-15V: RP6.1; also elsewhere on the board
-VLT: C26.-, C28.-, IC14.4 (V-), IC15.4 (V-), IC17.4 (V-), IC18.4 (V-), IC19.4 (V-), R118.2, RP6.2
ACCENT_LT: IC18.5 (+IN); also elsewhere on the board
GND: C16.1, C17.1, C21.-, C22.-, C23.-, C24.1, C25.1, C26.+, C27.-, C28.+, C29.-, D20.C, D21.A, D22.C, D23.A, D27.A, D28.C, IC14.5 (+IN), IC15.5 (+IN), IC17.5 (+IN), IC18.3 (+IN), IC19.5 (+IN), Q16.E, R67.2, R79.2, R85.2, R94.2, R98.1, R99.1, R111.2, R112.1, R115.1, R120.2, VR10.M1, VR11.M1, VR12.M1; also elsewhere on the board
LT_OUT: IC18.1 (OUT), J1.3, VR12.2 (S), VR12.3 (E)
unnamed: C18.1, IC15.6 (-IN), Q13.E, R73.1
unnamed: Q13.C, R71.2
unnamed: IC14.1 (OUT), R68.2
unnamed: IC14.7 (OUT), R65.2
unnamed: IC14.6 (-IN), R60.1, R61.1, R64.2, R66.2
unnamed: D16.A, IC16.7 (VSS), R64.1, R65.1
unnamed: D16.C, IC14.2 (-IN), IC16.14 (VDD), R66.1, R68.1
unnamed: R113.1, VR10.3 (E)
unnamed: R112.2, VR10.1 (A)
unnamed: IC14.3 (+IN), VR10.2 (S)
unnamed: IC15.3 (+IN), R67.1, R69.2
unnamed: IC15.2 (-IN), R62.2, R63.2
unnamed: IC15.1 (OUT), R69.1, R70.2
unnamed: IC16.1 (I), IC16.13 (I), R70.1
unnamed: IC16.2 (O), IC16.12 (O), R73.2
unnamed: Q13.B, R72.2
unnamed: C18.2, IC15.7 (OUT), R63.1, R71.1, R102.2, R103.2
unnamed: D13.C, R62.1
unnamed: C20.1, IC19.6 (-IN), Q22.E, R75.1
unnamed: Q22.C, R84.2
unnamed: IC19.3 (+IN), R85.1, R86.2
unnamed: IC19.2 (-IN), R87.2, R88.2
unnamed: IC19.1 (OUT), R83.2, R86.1
unnamed: IC16.3 (I), IC16.5 (I), R83.1
unnamed: IC16.4 (O), IC16.6 (O), R75.2
unnamed: Q22.B, R76.2
unnamed: C20.2, IC19.7 (OUT), R84.1, R87.1, R117.2
unnamed: D32.C, R88.1
unnamed: C19.1, IC17.6 (-IN), Q14.E, R78.1
unnamed: Q14.C, R77.2
unnamed: IC17.3 (+IN), R79.1, R81.2
unnamed: IC17.2 (-IN), R82.2, R89.2
unnamed: IC17.1 (OUT), R80.2, R81.1
unnamed: IC16.9 (I), IC16.11 (I), R80.1
unnamed: IC16.8 (O), IC16.10 (O), R78.2
unnamed: Q14.B, R74.2
unnamed: C19.2, IC17.7 (OUT), R77.1, R82.1, R105.2
unnamed: D33.C, R89.1
unnamed: C21.+, D19.C, R100.1, VR11.1 (A)
unnamed: C17.2, D14.C, R61.2
unnamed: C16.2, D15.C, R60.2
unnamed: D13.A, D14.A, D15.A, D17.A, D32.A, D33.A, Q15.C, R72.1, R74.1, R76.1
unnamed: Q19.B, R107.1, R108.1
unnamed: Q19.C, R99.2, R104.1
unnamed: D20.A, D21.C, Q18.E, R103.1, R104.2
unnamed: Q21.B, R110.1
unnamed: Q21.C, R114.2, R115.2, R116.1
unnamed: D27.C, D28.A, R116.2, R117.1
unnamed: Q20.B, R109.1
unnamed: Q20.C, R98.2, R106.1
unnamed: D22.A, D23.C, R105.1, R106.2
unnamed: Q18.C, R102.1
unnamed: C24.2, D17.C, R101.1
unnamed: Q18.B, R101.2
unnamed: R111.1, VR11.2 (S), VR11.3 (E)
unnamed: IC18.2 (-IN), Q19.E, Q20.E, Q21.E, VR12.1 (A)
unnamed: C23.+, R100.2, R108.2, R109.2
unnamed: C25.2, D25.C, R110.2
unnamed: C22.+, D24.C, R107.2
unnamed: Q17.E, R96.2
unnamed: Q17.B, R97.1
unnamed: D18.C, Q16.C, R92.2
unnamed: IC18.6 (-IN), R118.1, R119.2, R120.1
unnamed: IC18.7 (OUT), R95.1, R96.1, R119.1
unnamed: D18.A, R95.2, R97.2
unnamed: Q16.B, R93.2, R94.1
unnamed: Q15.E, R91.2
unnamed: Q15.B, R90.2, R92.1
TOM_NOISE: R114.1; also elsewhere on the board
TO_NOISE_LT: D19.A, D24.A, D25.A, Q17.C; also elsewhere on the board
TRIG_LT: R93.1; also elsewhere on the board

Notes on the sheet:
LowTom

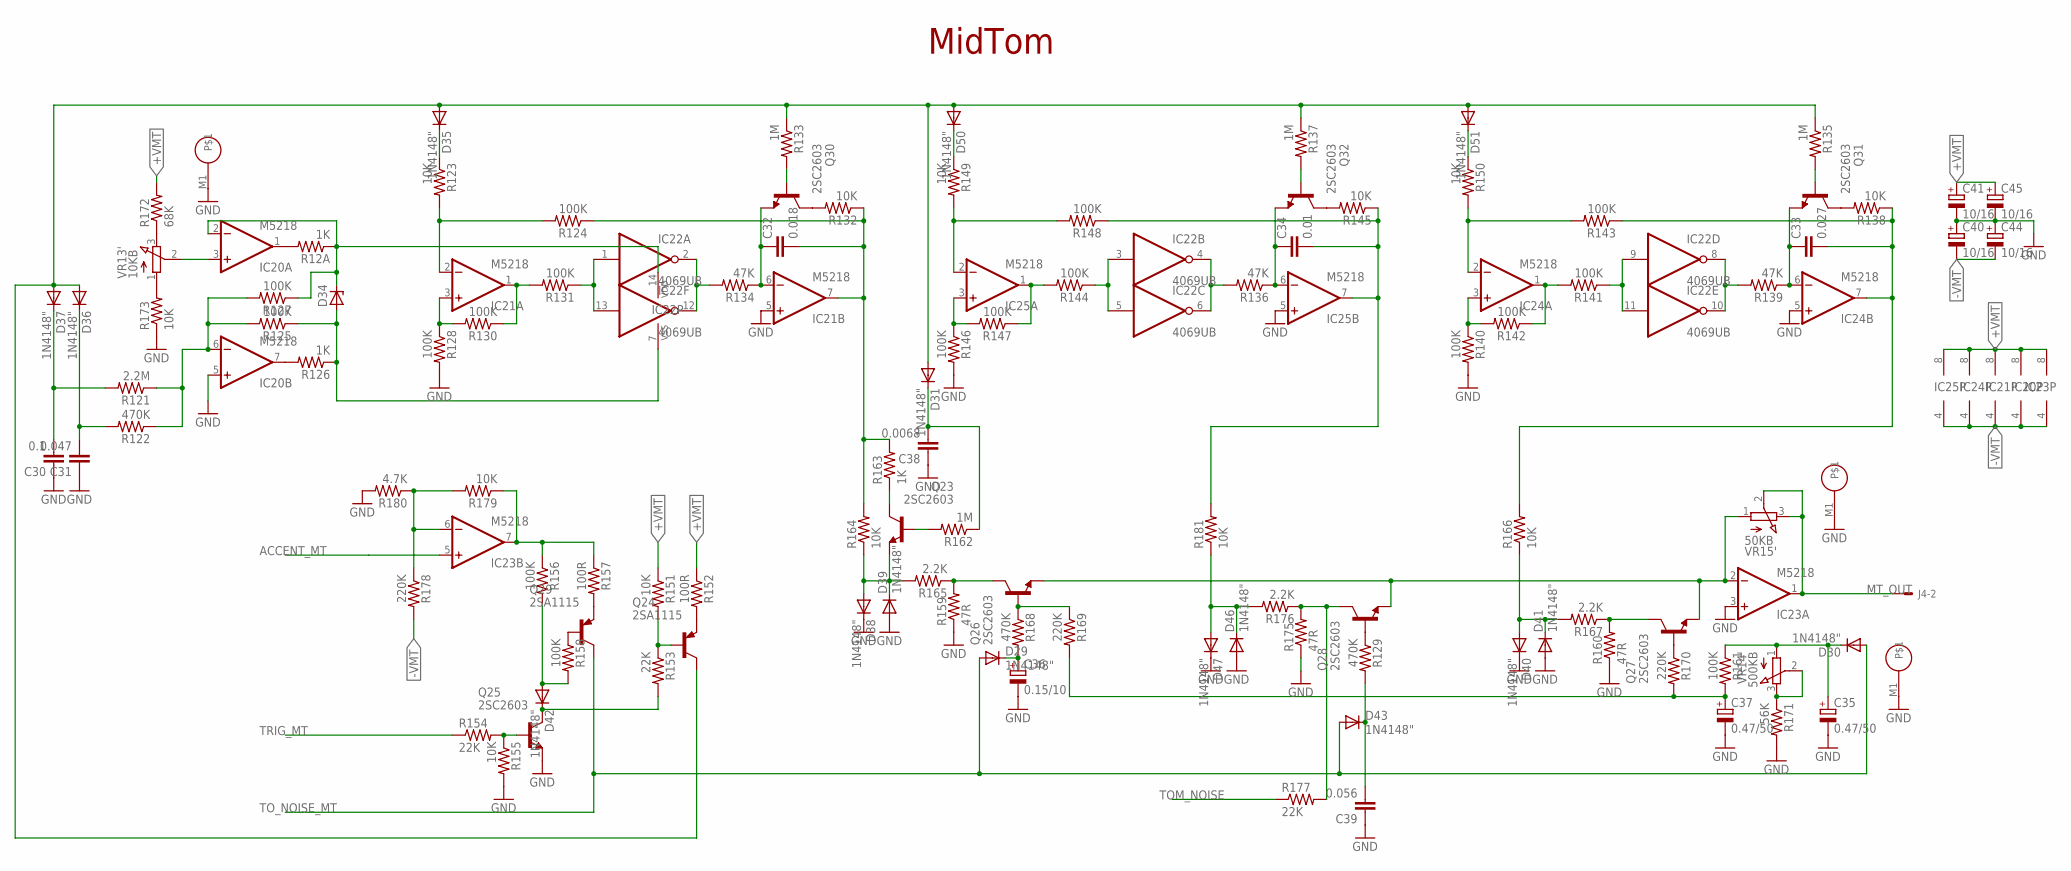
[picture p5: schematic Nava_v1.02.sch, sheet 5, MT]

Parts:
C30: 0.1; C050-025X075
C31: 0.047; C050-025X075
C32: 0.018; C050-025X075
C33: 0.027; C050-025X075
C34: 0.01; C050-025X075
C35, C37: 0.47/50; E2-5
C36: 0.15/10; E2-5
C38: 0.0068; C050-025X075
C39: 0.056; C050-025X075
C40, C41, C44, C45: 10/16; E2-5
D29, D30, D31, D35, D36, D37, D38, D39, D40, D41, D42, D43, D46, D47, D50, D51: 1N4148"; DO35-7C
D34: ZENER-DIODE; DO41-7
IC20, IC21, IC23, IC24, IC25: M5218; SIL8
IC22: 4069UB; DIL14
J4: 22-27-2041-04; 6410-04
Q23, Q25, Q26, Q27, Q28, Q30, Q31, Q32: 2SC2603; TO92-ECB
Q24, Q29: 2SA1115; TO92-ECB-PNP
R12A, R126, R163: 1K; 0207/7
R121: 2.2M; 0207/7
R122, R129, R168: 470K; 0207/7
R123, R132, R138, R145, R149, R150, R151, R155, R164, R166, R173, R179, R181: 10K; 0207/7
R124, R125, R127, R128, R130, R131, R140, R141, R142, R143, R144, R146, R147, R148, R156, R158, R161: 100K; 0207/7
R133, R135, R137, R162: 1M; 0207/7
R134, R136, R139: 47K; 0207/7
R152, R157: 100R; 0207/7
R153, R154, R177: 22K; 0207/7
R159, R160, R175: 47R; 0207/7
R165, R167, R176: 2.2K; 0207/7
R169, R170, R178: 220K; 0207/7
R171: 56K; 0207/7
R172: 68K; 0207/7
R180: 4.7K; 0207/7
VR13: 10KB; EVUF
VR14: 500KB; EVUF
VR15: 50KB; EVUF

Connections:
+VMT: C41.+, C45.+, IC20.8 (V+), IC21.8 (V+), IC23.8 (V+), IC24.8 (V+), IC25.8 (V+), R151.1, R152.1, R172.2; also elsewhere on the board
-VMT: C40.-, C44.-, IC20.4 (V-), IC21.4 (V-), IC23.4 (V-), IC24.4 (V-), IC25.4 (V-), R178.2; also elsewhere on the board
ACCENT_MT: IC23.5 (+IN); also elsewhere on the board
GND: C30.1, C31.1, C35.-, C36.-, C37.-, C38.1, C39.1, C40.+, C41.-, C44.+, C45.-, D38.C, D39.A, D40.C, D41.A, D46.A, D47.C, IC20.5 (+IN), IC21.5 (+IN), IC23.3 (+IN), IC24.5 (+IN), IC25.5 (+IN), Q25.E, R128.2, R140.2, R146.2, R155.2, R159.1, R160.1, R171.2, R173.1, R175.1, R180.2, VR13.M1, VR14.M1, VR15.M1; also elsewhere on the board
MT_OUT: IC23.1 (OUT), J4.2, VR15.2 (S), VR15.3 (E)
unnamed: C32.1, IC21.6 (-IN), Q30.E, R134.1
unnamed: Q30.C, R132.2
unnamed: IC20.1 (OUT), R12A.2
unnamed: IC20.7 (OUT), R126.2
unnamed: IC20.6 (-IN), R121.1, R122.1, R125.2, R127.2
unnamed: D34.A, IC22.7 (VSS), R125.1, R126.1
unnamed: D34.C, IC20.2 (-IN), IC22.14 (VDD), R12A.1, R127.1
unnamed: R172.1, VR13.3 (E)
unnamed: R173.2, VR13.1 (A)
unnamed: IC20.3 (+IN), VR13.2 (S)
unnamed: IC21.3 (+IN), R128.1, R130.2
unnamed: IC21.2 (-IN), R123.2, R124.2
unnamed: IC21.1 (OUT), R130.1, R131.2
unnamed: IC22.1 (I), IC22.13 (I), R131.1
unnamed: IC22.2 (O), IC22.12 (O), R134.2
unnamed: Q30.B, R133.2
unnamed: C32.2, IC21.7 (OUT), R124.1, R132.1, R163.2, R164.2
unnamed: D35.C, R123.1
unnamed: C34.1, IC25.6 (-IN), Q32.E, R136.1
unnamed: Q32.C, R145.2
unnamed: IC25.3 (+IN), R146.1, R147.2
unnamed: IC25.2 (-IN), R148.2, R149.2
unnamed: IC25.1 (OUT), R144.2, R147.1
unnamed: IC22.3 (I), IC22.5 (I), R144.1
unnamed: IC22.4 (O), IC22.6 (O), R136.2
unnamed: Q32.B, R137.2
unnamed: C34.2, IC25.7 (OUT), R145.1, R148.1, R181.2
unnamed: D50.C, R149.1
unnamed: C33.1, IC24.6 (-IN), Q31.E, R139.1
unnamed: Q31.C, R138.2
unnamed: IC24.3 (+IN), R140.1, R142.2
unnamed: IC24.2 (-IN), R143.2, R150.2
unnamed: IC24.1 (OUT), R141.2, R142.1
unnamed: IC22.9 (I), IC22.11 (I), R141.1
unnamed: IC22.8 (O), IC22.10 (O), R139.2
unnamed: Q31.B, R135.2
unnamed: C33.2, IC24.7 (OUT), R138.1, R143.1, R166.2
unnamed: D51.C, R150.1
unnamed: C31.2, D36.C, R122.2
unnamed: C30.2, D37.C, R121.2
unnamed: D31.A, D35.A, D36.A, D37.A, D50.A, D51.A, Q24.C, R133.1, R135.1, R137.1
unnamed: Q26.B, R168.1, R169.1
unnamed: Q26.C, R159.2, R165.1
unnamed: D38.A, D39.C, Q23.E, R164.1, R165.2
unnamed: Q28.B, R129.1
unnamed: Q28.C, R175.2, R176.1, R177.2
unnamed: D46.C, D47.A, R176.2, R181.1
unnamed: Q27.B, R170.1
unnamed: Q27.C, R160.2, R167.1
unnamed: D40.A, D41.C, R166.1, R167.2
unnamed: Q23.C, R163.1
unnamed: C38.2, D31.C, R162.1
unnamed: Q23.B, R162.2
unnamed: IC23.2 (-IN), Q26.E, Q27.E, Q28.E, VR15.1 (A)
unnamed: C35.+, D30.C, R161.1, VR14.1 (A)
unnamed: R171.1, VR14.2 (S), VR14.3 (E)
unnamed: C37.+, R161.2, R169.2, R170.2
unnamed: C39.2, D43.C, R129.2
unnamed: C36.+, D29.C, R168.2
unnamed: Q29.E, R157.2
unnamed: Q29.B, R158.1
unnamed: D42.C, Q25.C, R153.2
unnamed: IC23.6 (-IN), R178.1, R179.2, R180.1
unnamed: IC23.7 (OUT), R156.1, R157.1, R179.1
unnamed: D42.A, R156.2, R158.2
unnamed: Q25.B, R154.2, R155.1
unnamed: Q24.E, R152.2
unnamed: Q24.B, R151.2, R153.1
TOM_NOISE: R177.1; also elsewhere on the board
TO_NOISE_MT: D29.A, D30.A, D43.A, Q29.C; also elsewhere on the board
TRIG_MT: R154.1; also elsewhere on the board

Notes on the sheet:
MidTom

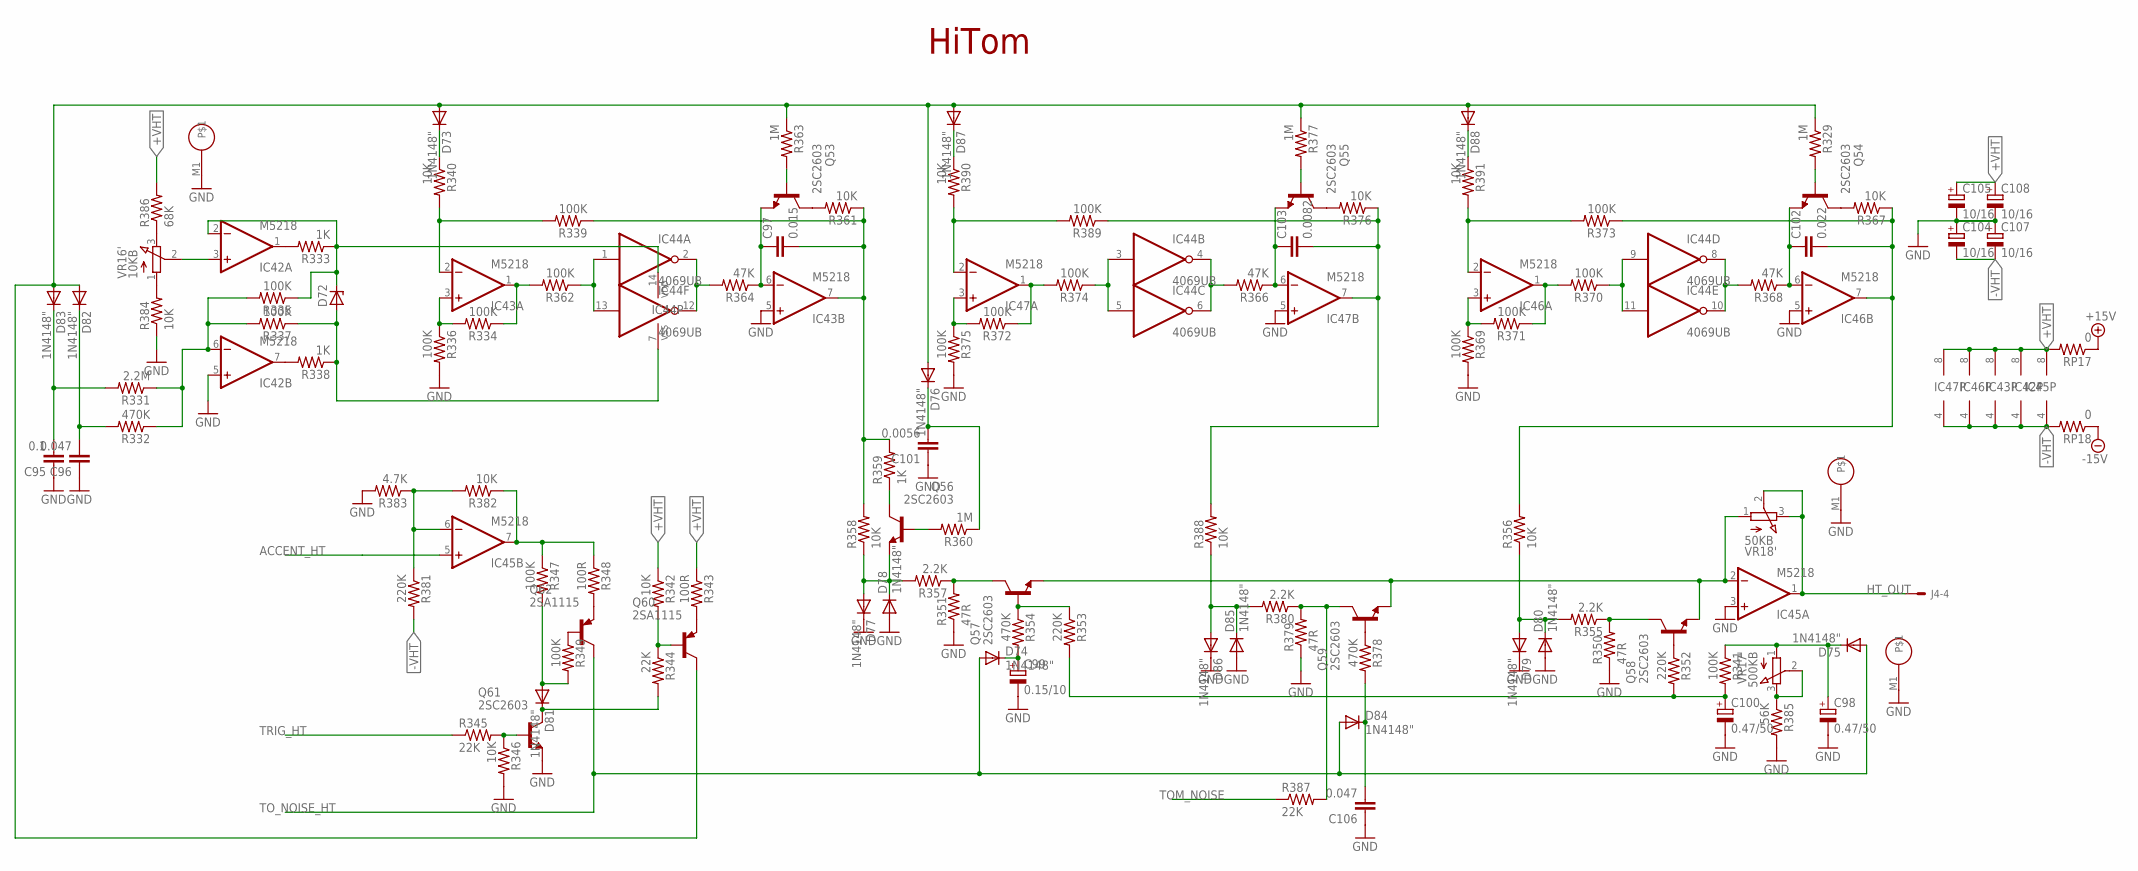
[picture p6: schematic Nava_v1.02.sch, sheet 6, HT]

Parts:
C95: 0.1; C050-025X075
C96, C106: 0.047; C050-025X075
C97: 0.015; C050-025X075
C98, C100: 0.47/50; E2-5
C99: 0.15/10; E2-5
C101: 0.0056; C050-025X075
C102: 0.022; C050-025X075
C103: 0.0082; C050-025X075
C104, C105, C107, C108: 10/16; E2-5
D72: ZENER-DIODE; DO41-7
D73, D74, D75, D76, D77, D78, D79, D80, D81, D82, D83, D84, D85, D86, D87, D88: 1N4148"; DO35-7C
IC42, IC43, IC45, IC46, IC47: M5218; SIL8
IC44: 4069UB; DIL14
J4: 22-27-2041-04; 6410-04
Q53, Q54, Q55, Q56, Q57, Q58, Q59, Q61: 2SC2603; TO92-ECB
Q60, Q62: 2SA1115; TO92-ECB-PNP
R329, R360, R363, R377: 1M; 0207/7
R331: 2.2M; 0207/7
R332, R354, R378: 470K; 0207/7
R333, R338, R359: 1K; 0207/7
R334, R335, R336, R337, R339, R341, R347, R349, R362, R369, R370, R371, R372, R373, R374, R375, R389: 100K; 0207/7
R340, R342, R346, R356, R358, R361, R367, R376, R382, R384, R388, R390, R391: 10K; 0207/7
R343, R348: 100R; 0207/7
R344, R345, R387: 22K; 0207/7
R350, R351, R379: 47R; 0207/7
R352, R353, R381: 220K; 0207/7
R355, R357, R380: 2.2K; 0207/7
R364, R366, R368: 47K; 0207/7
R383: 4.7K; 0207/7
R385: 56K; 0207/7
R386: 68K; 0207/7
RP17, RP18: 0; 0207/7
VR16: 10KB; EVUF
VR17: 500KB; EVUF
VR18: 50KB; EVUF

Connections:
+15V: RP17.1; also elsewhere on the board
+VHT: C105.+, C108.+, IC42.8 (V+), IC43.8 (V+), IC45.8 (V+), IC46.8 (V+), IC47.8 (V+), R342.1, R343.1, R386.2, RP17.2
-15V: RP18.1; also elsewhere on the board
-VHT: C104.-, C107.-, IC42.4 (V-), IC43.4 (V-), IC45.4 (V-), IC46.4 (V-), IC47.4 (V-), R381.2, RP18.2
ACCENT_HT: IC45.5 (+IN); also elsewhere on the board
GND: C95.1, C96.1, C98.-, C99.-, C100.-, C101.1, C104.+, C105.-, C106.1, C107.+, C108.-, D77.C, D78.A, D79.C, D80.A, D85.A, D86.C, IC42.5 (+IN), IC43.5 (+IN), IC45.3 (+IN), IC46.5 (+IN), IC47.5 (+IN), Q61.E, R336.2, R346.2, R350.1, R351.1, R369.2, R375.2, R379.1, R383.2, R384.1, R385.2, VR16.M1, VR17.M1, VR18.M1; also elsewhere on the board
HT_OUT: IC45.1 (OUT), J4.4, VR18.2 (S), VR18.3 (E)
unnamed: C97.1, IC43.6 (-IN), Q53.E, R364.1
unnamed: Q53.C, R361.2
unnamed: IC42.1 (OUT), R333.2
unnamed: IC42.7 (OUT), R338.2
unnamed: IC42.6 (-IN), R331.1, R332.1, R335.2, R337.2
unnamed: D72.A, IC44.7 (VSS), R337.1, R338.1
unnamed: D72.C, IC42.2 (-IN), IC44.14 (VDD), R333.1, R335.1
unnamed: R386.1, VR16.3 (E)
unnamed: R384.2, VR16.1 (A)
unnamed: IC42.3 (+IN), VR16.2 (S)
unnamed: IC43.3 (+IN), R334.2, R336.1
unnamed: IC43.2 (-IN), R339.2, R340.2
unnamed: IC43.1 (OUT), R334.1, R362.2
unnamed: IC44.1 (I), IC44.13 (I), R362.1
unnamed: IC44.2 (O), IC44.12 (O), R364.2
unnamed: Q53.B, R363.2
unnamed: C97.2, IC43.7 (OUT), R339.1, R358.2, R359.2, R361.1
unnamed: D73.C, R340.1
unnamed: C103.1, IC47.6 (-IN), Q55.E, R366.1
unnamed: Q55.C, R376.2
unnamed: IC47.3 (+IN), R372.2, R375.1
unnamed: IC47.2 (-IN), R389.2, R390.2
unnamed: IC47.1 (OUT), R372.1, R374.2
unnamed: IC44.3 (I), IC44.5 (I), R374.1
unnamed: IC44.4 (O), IC44.6 (O), R366.2
unnamed: Q55.B, R377.2
unnamed: C103.2, IC47.7 (OUT), R376.1, R388.2, R389.1
unnamed: D87.C, R390.1
unnamed: C102.1, IC46.6 (-IN), Q54.E, R368.1
unnamed: Q54.C, R367.2
unnamed: IC46.3 (+IN), R369.1, R371.2
unnamed: IC46.2 (-IN), R373.2, R391.2
unnamed: IC46.1 (OUT), R370.2, R371.1
unnamed: IC44.9 (I), IC44.11 (I), R370.1
unnamed: IC44.8 (O), IC44.10 (O), R368.2
unnamed: Q54.B, R329.2
unnamed: C102.2, IC46.7 (OUT), R356.2, R367.1, R373.1
unnamed: D88.C, R391.1
unnamed: C96.2, D82.C, R332.2
unnamed: C95.2, D83.C, R331.2
unnamed: D73.A, D76.A, D82.A, D83.A, D87.A, D88.A, Q60.C, R329.1, R363.1, R377.1
unnamed: Q57.B, R353.1, R354.1
unnamed: Q57.C, R351.2, R357.1
unnamed: D77.A, D78.C, Q56.E, R357.2, R358.1
unnamed: Q59.B, R378.1
unnamed: Q59.C, R379.2, R380.1, R387.2
unnamed: D85.C, D86.A, R380.2, R388.1
unnamed: Q58.B, R352.1
unnamed: Q58.C, R350.2, R355.1
unnamed: D79.A, D80.C, R355.2, R356.1
unnamed: Q56.C, R359.1
unnamed: C101.2, D76.C, R360.1
unnamed: Q56.B, R360.2
unnamed: IC45.2 (-IN), Q57.E, Q58.E, Q59.E, VR18.1 (A)
unnamed: C98.+, D75.C, R341.1, VR17.1 (A)
unnamed: R385.1, VR17.2 (S), VR17.3 (E)
unnamed: C100.+, R341.2, R352.2, R353.2
unnamed: C106.2, D84.C, R378.2
unnamed: C99.+, D74.C, R354.2
unnamed: Q62.E, R348.2
unnamed: Q62.B, R349.1
unnamed: D81.C, Q61.C, R344.2
unnamed: IC45.6 (-IN), R381.1, R382.2, R383.1
unnamed: IC45.7 (OUT), R347.1, R348.1, R382.1
unnamed: D81.A, R347.2, R349.2
unnamed: Q61.B, R345.2, R346.1
unnamed: Q60.E, R343.2
unnamed: Q60.B, R342.2, R344.1
TOM_NOISE: R387.1; also elsewhere on the board
TO_NOISE_HT: D74.A, D75.A, D84.A, Q62.C; also elsewhere on the board
TRIG_HT: R345.1; also elsewhere on the board

Notes on the sheet:
HiTom

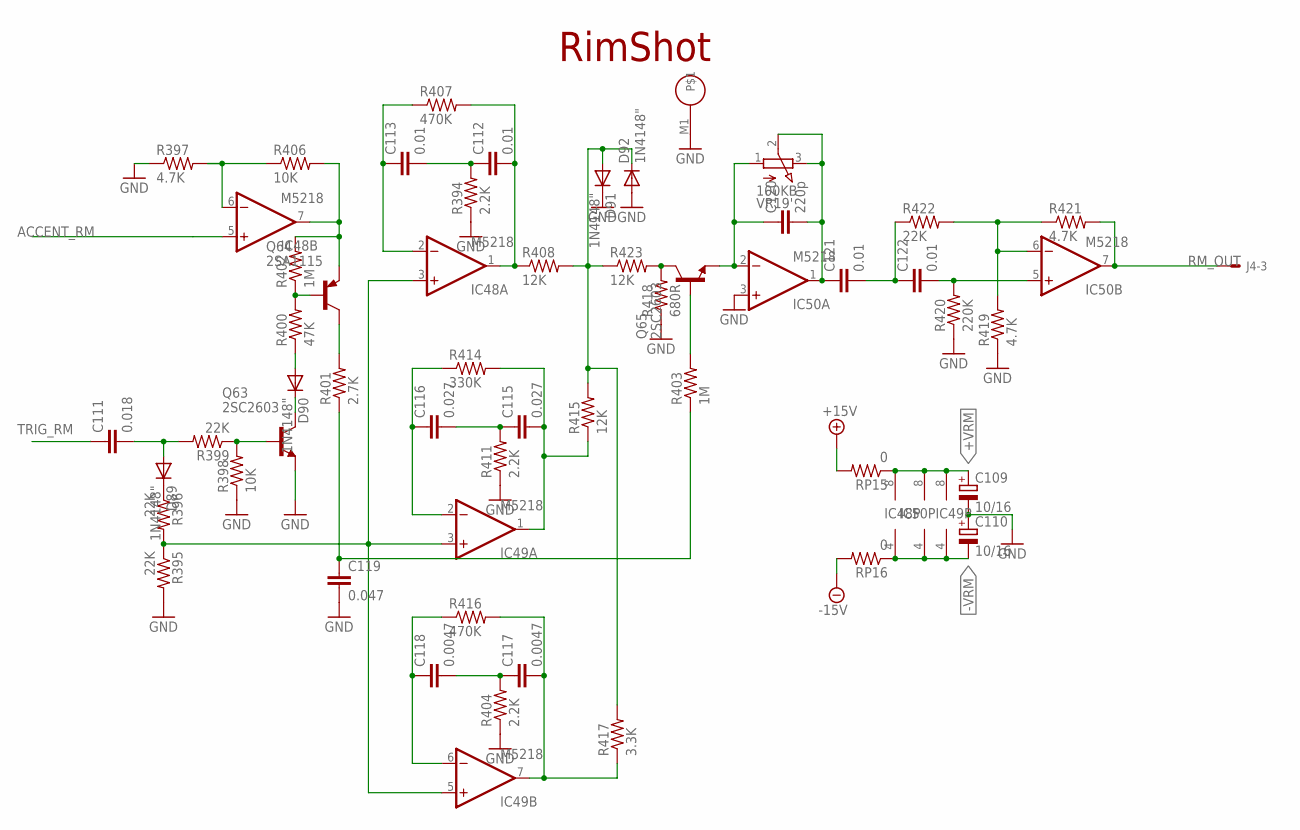
[picture p7: schematic Nava_v1.02.sch, sheet 7, RM]

Parts:
C109, C110: 10/16; E2-5
C111: 0.018; C050-025X075
C112, C113, C121, C122: 0.01; C050-025X075
C115, C116: 0.027; C050-025X075
C117, C118: 0.0047; C050-025X075
C119: 0.047; C050-025X075
C120: 220p; C050-025X075
D89, D90, D91, D92: 1N4148"; DO35-7C
IC48, IC49, IC50: M5218; SIL8
J4: 22-27-2041-04; 6410-04
Q63, Q65: 2SC2603; TO92-ECB
Q64: 2SA1115; TO92-ECB-PNP
R394, R404, R411: 2.2K; 0207/7
R395, R396, R399, R422: 22K; 0207/7
R397, R419, R421: 4.7K; 0207/7
R398, R406: 10K; 0207/7
R400: 47K; 0207/7
R401: 2.7K; 0207/7
R402, R403: 1M; 0207/7
R407, R416: 470K; 0207/7
R408, R415, R423: 12K; 0207/7
R414: 330K; 0207/7
R417: 3.3K; 0207/7
R418: 680R; 0207/7
R420: 220K; 0207/7
RP15, RP16: 0; 0207/7
VR19: 100KB; EVUF

Connections:
+15V: RP15.2; also elsewhere on the board
+VRM: C109.+, IC48.8 (V+), IC49.8 (V+), IC50.8 (V+), RP15.1
-15V: RP16.2; also elsewhere on the board
-VRM: C110.-, IC48.4 (V-), IC49.4 (V-), IC50.4 (V-), RP16.1
ACCENT_RM: IC48.5 (+IN); also elsewhere on the board
C117: C117.2, IC49.7 (OUT), R416.2, R417.1
GND: C109.-, C110.+, C119.2, D91.C, D92.A, IC50.3 (+IN), Q63.E, R394.1, R395.2, R397.1, R398.1, R404.1, R411.1, R418.1, R419.1, R420.1, VR19.M1; also elsewhere on the board
unnamed: C115.1, C116.2, R411.2
unnamed: C116.1, IC49.2 (-IN), R414.1
unnamed: C115.2, IC49.1 (OUT), R414.2, R415.1
unnamed: C112.1, C113.2, R394.2
unnamed: C113.1, IC48.2 (-IN), R407.1
unnamed: C112.2, IC48.1 (OUT), R407.2, R408.1
unnamed: C117.1, C118.2, R404.2
unnamed: C118.1, IC49.6 (-IN), R416.1
unnamed: Q64.B, R400.2, R402.1
unnamed: Q63.B, R398.2, R399.1
unnamed: D89.C, R396.1
unnamed: IC48.3 (+IN), IC49.3 (+IN), IC49.5 (+IN), R395.1, R396.2
unnamed: C111.2, D89.A, R399.2
unnamed: D90.C, Q63.C
unnamed: D90.A, R400.1
unnamed: Q64.C, R401.2
unnamed: C119.1, R401.1, R403.1
unnamed: IC48.7 (OUT), Q64.E, R402.2, R406.2
unnamed: IC48.6 (-IN), R397.2, R406.1
unnamed: Q65.C, R418.2, R423.2
unnamed: D91.A, D92.C, R408.2, R415.2, R417.2, R423.1
unnamed: Q65.B, R403.2
unnamed: C120.1, IC50.2 (-IN), Q65.E, VR19.1 (A)
unnamed: C120.2, C121.1, IC50.1 (OUT), VR19.2 (S), VR19.3 (E)
unnamed: C121.2, C122.1, R422.1
unnamed: IC50.6 (-IN), R419.2, R421.1, R422.2
unnamed: C122.2, IC50.5 (+IN), R420.2
RM_OUT: IC50.7 (OUT), J4.3, R421.2
TRIG_RM: C111.1; also elsewhere on the board

Notes on the sheet:
RimShot

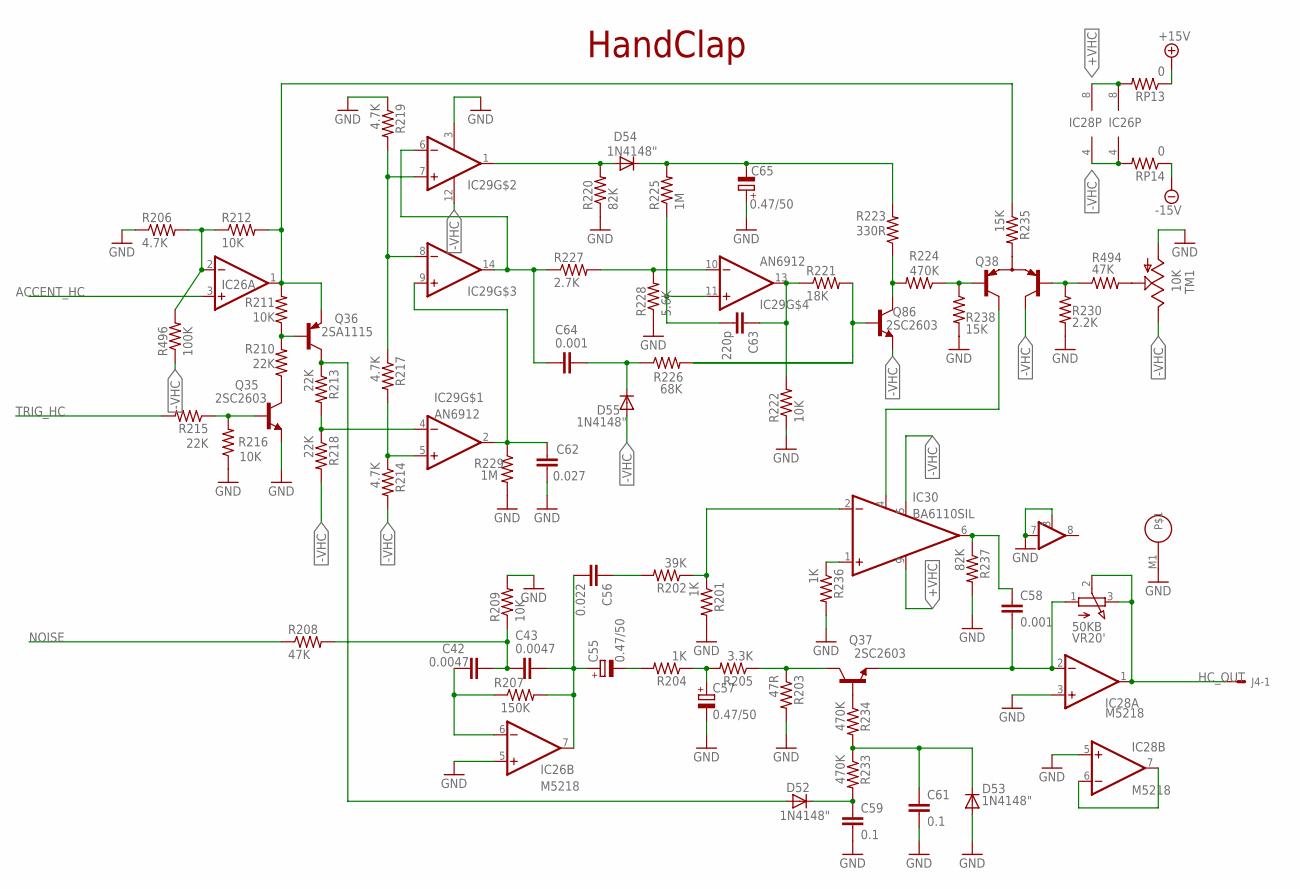
[picture p8: schematic Nava_v1.02.sch, sheet 8, HC]

Parts:
C42, C43: 0.0047; C050-025X075
C55, C57, C65: 0.47/50; E2-5
C56: 0.022; C050-025X075
C58, C64: 0.001; C050-025X075
C59, C61: 0.1; C050-025X075
C62: 0.027; C050-025X075
C63: 220p; C050-025X075
D52, D53, D54, D55: 1N4148"; DO35-7C
IC26, IC28: M5218; SIL8
IC29: AN6912; DIL14
IC30: BA6110SIL; SIL09
J4: 22-27-2041-04; 6410-04
Q35, Q37, Q86: 2SC2603; TO92-ECB
Q36: 2SA1115; TO92-ECB-PNP
Q38: 2SA798; SIP-5
R201, R204, R236: 1K; 0207/7
R202: 39K; 0207/7
R203: 47R; 0207/7
R205: 3.3K; 0207/7
R206, R214, R217, R219: 4.7K; 0207/7
R207: 150K; 0207/7
R208, R494: 47K; 0207/7
R209, R211, R212, R216, R222: 10K; 0207/7
R210, R213, R215, R218: 22K; 0207/7
R220, R237: 82K; 0207/7
R221: 18K; 0207/7
R223: 330R; 0207/7
R224, R233, R234: 470K; 0207/7
R225, R229: 1M; 0207/7
R226: 68K; 0207/7
R227: 2.7K; 0207/7
R228: 5.6K; 0207/7
R230: 2.2K; 0207/7
R235, R238: 15K; 0207/7
R496: 100K; 0207/7
RP13, RP14: 0; 0207/7
TM1: 10K; S64W
VR20: 50KB; EVUF

Connections:
+15V: RP13.1; also elsewhere on the board
+VHC: IC26.8 (V+), IC28.8 (V+), IC30.9 (V+), RP13.2
-15V: RP14.1; also elsewhere on the board
-VHC: D55.A, IC26.4 (V-), IC28.4 (V-), IC29.12 (V-), IC30.5 (V-), Q38.4 (C2), Q86.E, R214.2, R218.2, R496.1, RP14.2, TM1.E
ACCENT_HC: IC26.3 (+IN); also elsewhere on the board
GND: C57.-, C59.2, C61.2, C62.1, C65.+, D53.A, IC26.5 (+IN), IC28.3 (+IN), IC28.5 (+IN), IC29.3 (V+), IC30.3, IC30.7 (IN1), Q35.E, R201.2, R203.2, R206.1, R209.2, R216.1, R219.1, R220.1, R222.1, R228.1, R229.2, R230.2, R236.2, R237.2, R238.2, TM1.A, VR20.M1; also elsewhere on the board
HC_OUT: IC28.1 (OUT), J4.1, VR20.2 (S), VR20.3 (E)
unnamed: IC26.1 (OUT), Q36.E, R211.2, R212.2, R235.1
unnamed: IC26.2 (-IN), R206.2, R212.1, R496.2
unnamed: Q86.B, R221.2, R226.2
unnamed: C63.1, IC29.13 (OUT), R221.1, R222.2
unnamed: Q36.B, R210.2, R211.1
unnamed: Q35.C, R210.1
unnamed: D52.A, Q36.C, R213.1
unnamed: Q35.B, R215.1, R216.2
unnamed: C58.1, IC30.6 (OUT), R237.1
unnamed: IC29.4 (-IN), R213.2, R218.1
unnamed: IC29.5 (+IN), R214.1, R217.2
unnamed: IC29.7 (+IN), IC29.8 (-IN), R217.1, R219.2
unnamed: C64.2, IC29.6 (-IN), IC29.14 (OUT), R227.1
unnamed: C62.2, IC29.2 (OUT), IC29.9 (+IN), R229.1
unnamed: D54.A, IC29.1 (OUT), R220.2
unnamed: C65.-, D54.C, R223.2, R225.2
unnamed: C63.2, IC29.11 (+IN), R225.1
unnamed: IC29.10 (-IN), R227.2, R228.2
unnamed: C64.1, D55.C, R226.1
unnamed: Q86.C, R223.1, R224.2
unnamed: Q38.1 (B1), R224.1, R238.1
unnamed: R494.2, TM1.S
unnamed: Q37.B, R234.1
unnamed: C61.1, D53.C, R233.1, R234.2
unnamed: IC30.2 (-IN), R201.1, R202.1
unnamed: C56.1, R202.2
unnamed: C42.1, C43.2, R208.2, R209.1
unnamed: C42.2, IC26.6 (-IN), R207.1
unnamed: C43.1, C55.+, C56.2, IC26.7 (OUT), R207.2
unnamed: IC30.1 (+IN), R236.1
unnamed: C55.-, R204.2
unnamed: C57.+, R204.1, R205.2
unnamed: Q37.C, R203.1, R205.1
unnamed: C59.1, D52.C, R233.2
unnamed: C58.2, IC28.2 (-IN), Q37.E, VR20.1 (A)
unnamed: Q38.5 (B2), R230.1, R494.1
unnamed: Q38.3 (E), R235.2
unnamed: IC30.4 (C), Q38.2 (C1)
unnamed: IC28.6 (-IN), IC28.7 (OUT)
NOISE: R208.1; also elsewhere on the board
TRIG_HC: R215.2; also elsewhere on the board

Notes on the sheet:
HandClap
