e-licktronic/Nava-v1.0/Eagle/Nava_v1.02.brd

## EAGLE design Eagle/Nava_v1.02.brd (continued)

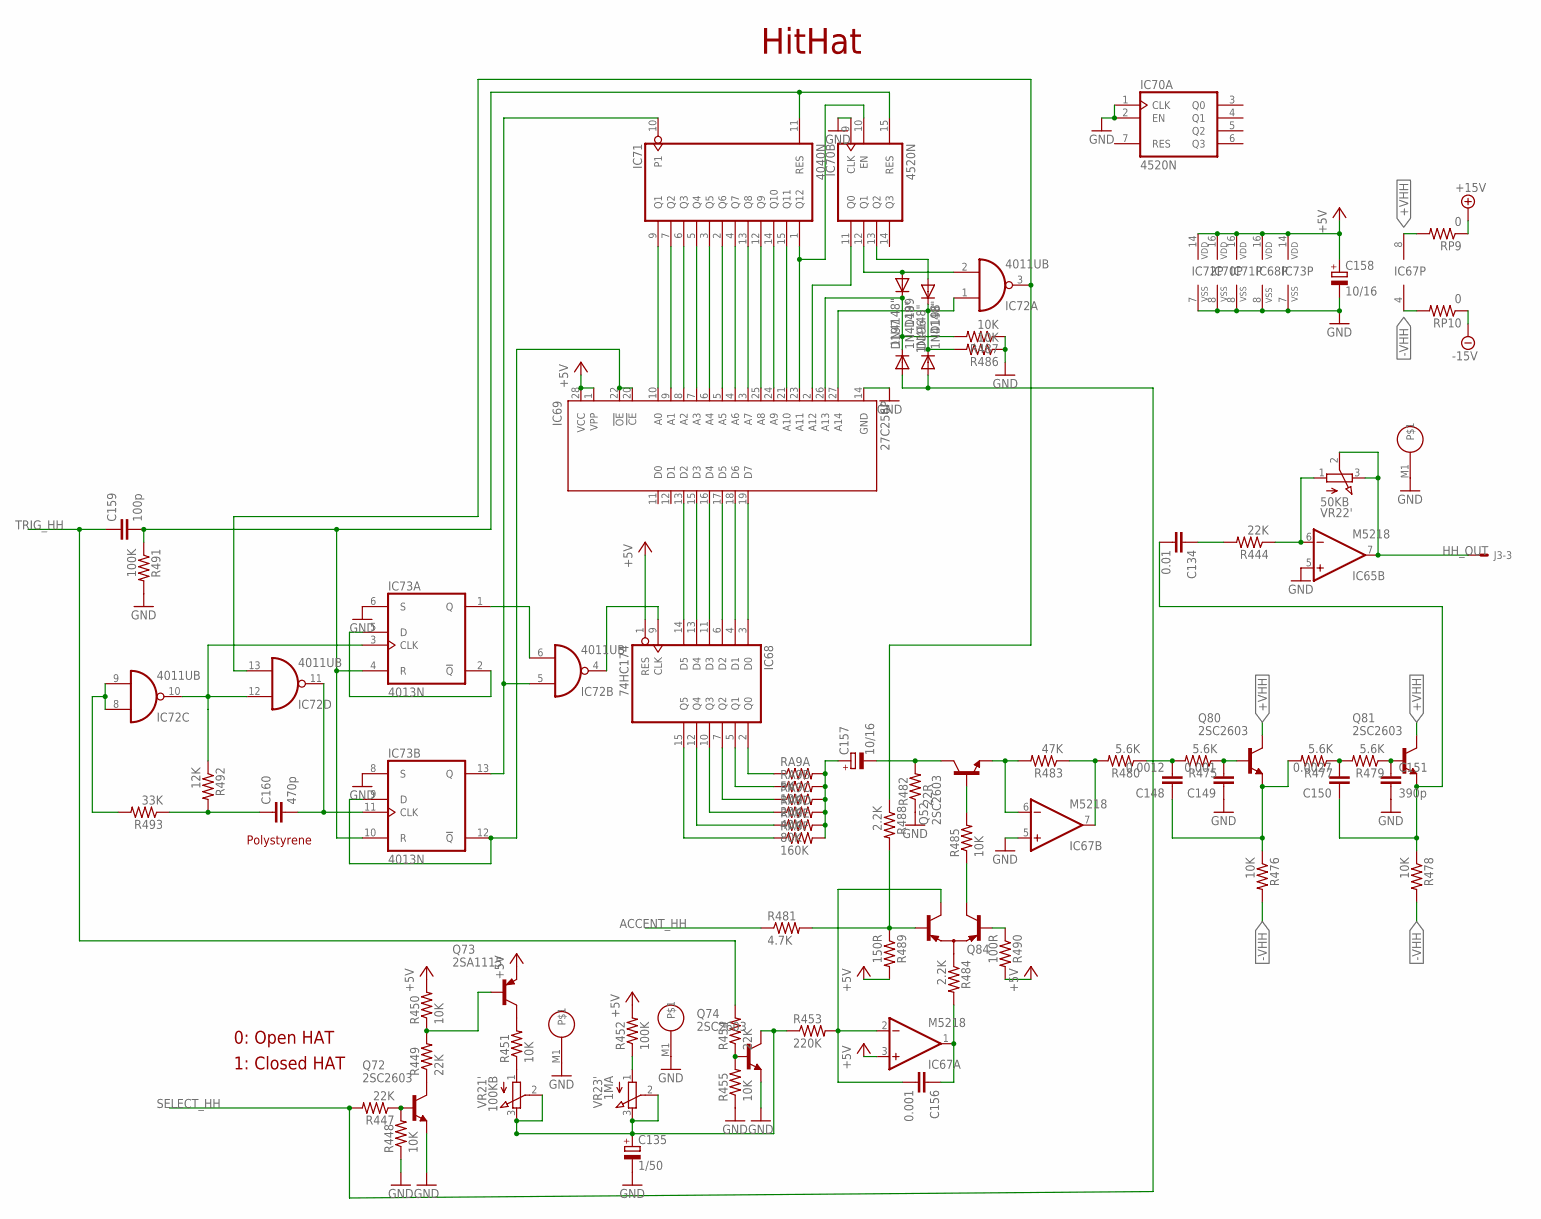
[picture p9: schematic Nava_v1.02.sch, sheet 9, HH]

Parts:
C134: 0.01; C050-025X075
C135: 1/50; E2-5
C148: 0.0012; C050-025X075
C149, C156: 0.001; C050-025X075
C150: 0.0027; C050-025X075
C151: 390p; C025_RE
C157, C158: 10/16; E2-5
C159: 100p; C050-025X075
C160: 470p; C025_RE
D196, D197, D198, D199: 1N4148"; DO35-7C
IC65, IC67: M5218; SIL8
IC68: 74HC174; DIL16
IC69: 27C256P; DIL28-6
IC70: 4520N; DIL16
IC71: 4040N; DIL16
IC72: 4011UB; DIL14
IC73: 4013N; DIL14
J3: 22-27-2041-04; 6410-04
Q52, Q72, Q74, Q80, Q81: 2SC2603; TO92-ECB
Q73: 2SA1115; TO92-ECB-PNP
Q84: 2SA798; SIP-5
R444, R447, R449, R454: 22K; 0207/7
R448, R450, R451, R455, R476, R478, R485, R486, R487: 10K; 0207/7
R452, R491: 100K; 0207/7
R453: 220K; 0207/7
R475, R477, R479, R480: 5.6K; 0207/7
R481: 4.7K; 0207/7
R482: 22R; 0207/7
R483: 47K; 0207/7
R484, R488: 2.2K; 0207/7
R489: 150R; 0207/7
R490: 100R; 0207/7
R492: 12K; 0207/7
R493: 33K; 0207/7
RA9A: 5K; 0207/7
RA9B: 10K; 0207/7
RA9C: 20K; 0207/7
RA9D: 40K; 0207/7
RA9E: 80K; 0207/7
RA9F: 160K; 0207/7
RP9, RP10: 0; 0207/7
VR21: 100KB; EVUF
VR22: 50KB; EVUF
VR23: 1MA; EVUF

Connections:
+5V: C158.+, IC67.3 (+IN), IC68.1 (RES), IC68.16 (VDD), IC69.1 (VPP), IC69.28 (VCC), IC70.16 (VDD), IC71.16 (VDD), IC72.14 (VDD), IC73.14 (VDD), Q73.E, R450.2, R452.2, R489.2, R490.2; also elsewhere on the board
+15V: RP9.1; also elsewhere on the board
+VHH: IC67.8 (V+), Q80.C, Q81.C, RP9.2; also elsewhere on the board
-15V: RP10.1; also elsewhere on the board
-VHH: IC67.4 (V-), R476.2, R478.2, RP10.2; also elsewhere on the board
ACCENT_HH: R481.1; also elsewhere on the board
CRASH_OUT2: C135.+, Q74.C, R453.1, VR21.2 (S), VR21.3 (E), VR23.2 (S), VR23.3 (E)
GND: C135.-, C149.1, C151.- (2), C158.-, IC65.5 (+IN), IC67.5 (+IN), IC68.8 (VSS), IC69.14 (GND), IC70.1 (CLK), IC70.2 (EN), IC70.8 (VSS), IC70.9 (CLK), IC71.8 (VSS), IC72.7 (VSS), IC73.6 (S), IC73.7 (VSS), IC73.8 (S), Q72.E, Q74.E, R448.1, R455.1, R482.1, R486.1, R487.1, R491.2, VR21.M1, VR22.M1, VR23.M1; also elsewhere on the board
HH_OUT: IC65.7 (OUT), J3.3, VR22.2 (S), VR22.3 (E)
HT_OUT3: IC72.10 (O), IC72.12 (I0), IC73.3 (CLK), R492.1
unnamed: IC72.8 (I0), IC72.9 (I1), R493.2
unnamed: C160.+ (1), R492.2, R493.1
unnamed: IC72.3 (O), IC72.13 (I1), R488.1
unnamed: C160.- (2), IC72.11 (O), IC73.11 (CLK)
unnamed: IC73.2 (!Q), IC73.5 (D)
unnamed: IC71.10 (P1), IC72.5 (I0), IC73.13 (Q)
unnamed: IC72.6 (I1), IC73.1 (Q)
unnamed: IC68.9 (CLK), IC72.4 (O)
unnamed: D197.C, D199.C, IC69.26 (A13), R487.2
unnamed: C157.+, RA9A.2, RA9B.2, RA9C.2, RA9D.2, RA9E.2, RA9F.2
unnamed: D196.C, D198.C, IC69.27 (A14), IC72.1 (I0), R486.2
unnamed: Q52.B, R485.2
unnamed: Q84.2 (C1), R485.1
unnamed: Q84.1 (B1), R490.1
unnamed: C157.-, Q52.C, R482.2
unnamed: Q84.3 (E), R484.1
unnamed: Q84.5 (B2), R481.2, R488.2, R489.1
unnamed: C150.2, R477.1, R479.2
unnamed: C148.2, R475.2, R480.1
unnamed: C149.2, Q80.B, R475.1
unnamed: C151.+ (1), Q81.B, R479.1
unnamed: IC67.6 (-IN), Q52.E, R483.2
unnamed: IC67.7 (OUT), R480.2, R483.1
unnamed: C148.1, Q80.E, R476.1, R477.2
unnamed: C134.2, C150.1, Q81.E, R478.1
unnamed: IC65.6 (-IN), R444.1, VR22.1 (A)
unnamed: C134.1, R444.2
unnamed: IC69.23 (A11), IC70.10 (EN), IC71.1 (Q12)
unnamed: IC69.5 (A5), IC71.2 (Q6)
unnamed: IC69.6 (A4), IC71.3 (Q5)
unnamed: IC69.4 (A6), IC71.4 (Q7)
unnamed: IC69.7 (A3), IC71.5 (Q4)
unnamed: IC69.8 (A2), IC71.6 (Q3)
unnamed: IC69.9 (A1), IC71.7 (Q2)
unnamed: IC69.10 (A0), IC71.9 (Q1)
unnamed: IC69.25 (A8), IC71.12 (Q9)
unnamed: IC69.3 (A7), IC71.13 (Q8)
unnamed: IC69.24 (A9), IC71.14 (Q10)
unnamed: IC69.21 (A10), IC71.15 (Q11)
unnamed: IC69.2 (A12), IC70.11 (Q0)
unnamed: D199.A, IC70.12 (Q1), IC72.2 (I1)
unnamed: D198.A, IC70.13 (Q2)
unnamed: Q74.B, R454.1, R455.2
unnamed: IC68.3 (D0), IC69.19 (D7)
unnamed: IC68.4 (D1), IC69.18 (D6)
unnamed: IC68.6 (D2), IC69.17 (D5)
unnamed: IC68.11 (D3), IC69.16 (D4)
unnamed: IC68.13 (D4), IC69.15 (D3)
unnamed: IC68.14 (D5), IC69.13 (D2)
unnamed: IC68.2 (Q0), RA9A.1
unnamed: IC68.5 (Q1), RA9B.1
unnamed: IC68.7 (Q2), RA9C.1
unnamed: IC68.10 (Q3), RA9D.1
unnamed: IC68.12 (Q4), RA9E.1
unnamed: IC68.15 (Q5), RA9F.1
unnamed: C156.1, IC67.1 (OUT), R484.2
unnamed: C159.2, IC70.15 (RES), IC71.11 (RES), IC73.4 (R), IC73.10 (R), R491.1
unnamed: C156.2, IC67.2 (-IN), Q84.4 (C2), R453.2
unnamed: IC69.20 (!CE), IC69.22 (!OE), IC73.9 (D), IC73.12 (!Q)
unnamed: R452.1, VR23.1 (A)
unnamed: R451.1, VR21.1 (A)
unnamed: Q73.C, R451.2
unnamed: Q72.C, R449.1
unnamed: Q73.B, R449.2, R450.1
unnamed: Q72.B, R447.1, R448.2
SELECT_HH: D196.A, D197.A, R447.2; also elsewhere on the board
TRIG_HH: C159.1, R454.2; also elsewhere on the board

Notes on the sheet:
HitHat
0: Open HAT
1: Closed HAT
Polystyrene

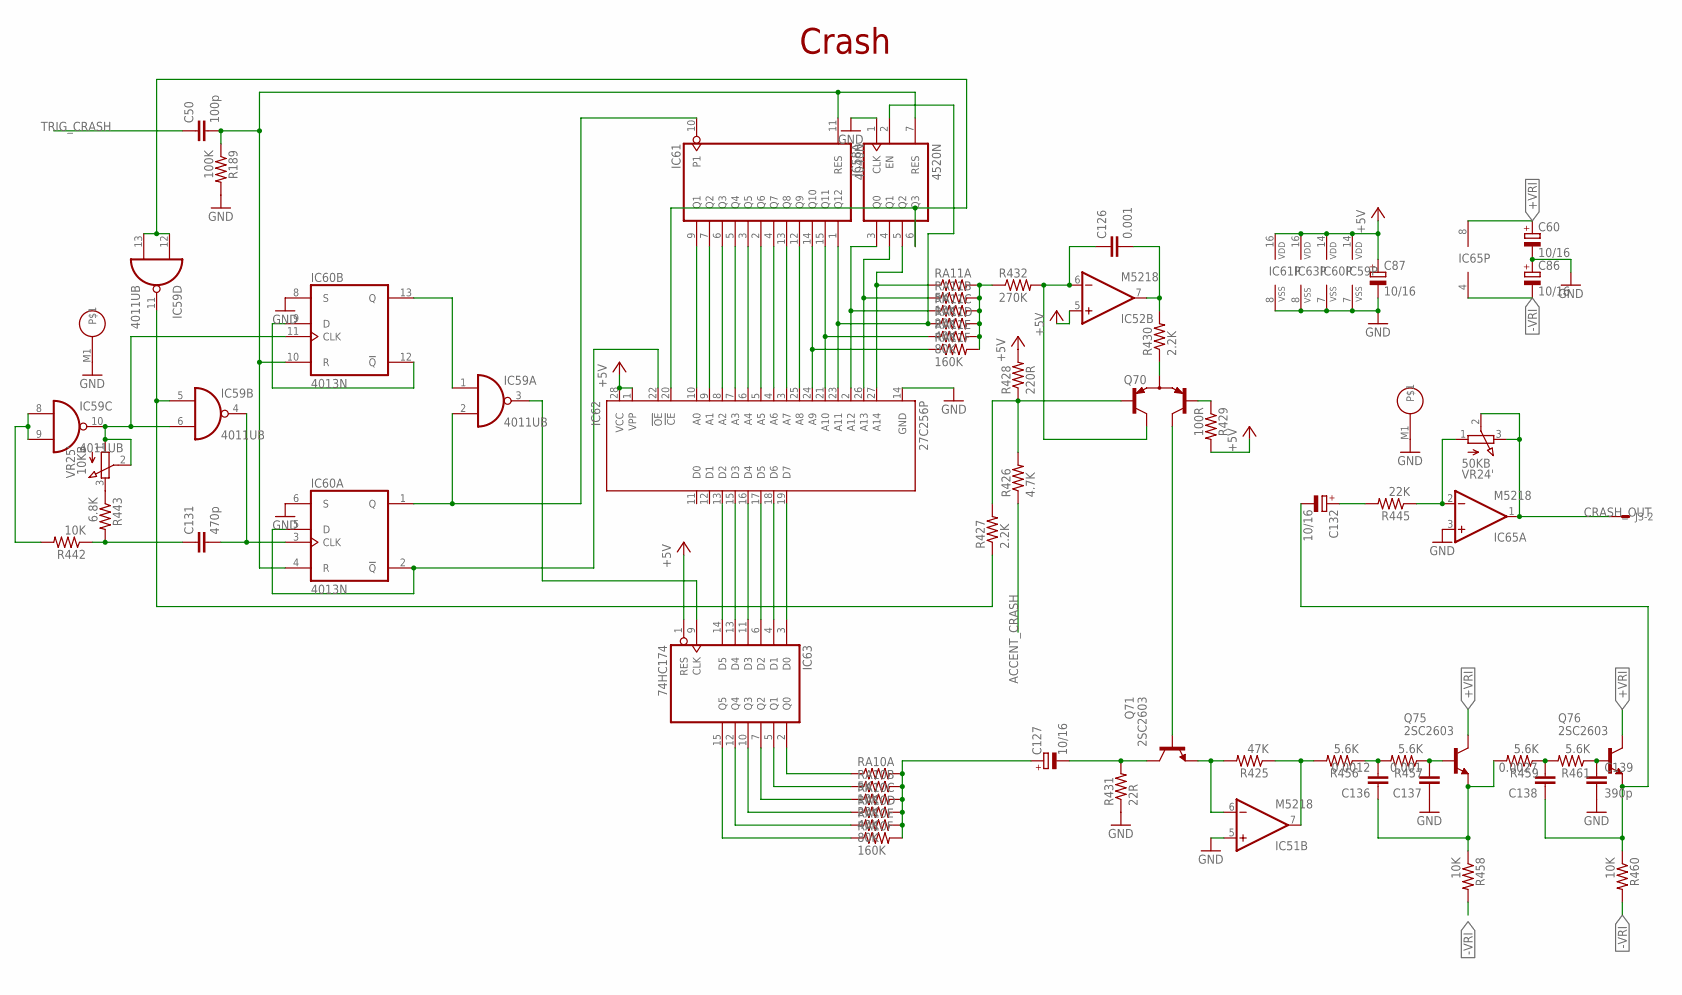
[picture p10: schematic Nava_v1.02.sch, sheet 10, CRASH]

Parts:
C50: 100p; C050-025X075
C60, C86, C87, C127, C132: 10/16; E2-5
C126, C137: 0.001; C050-025X075
C131: 470p; C025_RE
C136: 0.0012; C050-025X075
C138: 0.0027; C050-025X075
C139: 390p; C025_RE
IC51, IC52, IC65: M5218; SIL8
IC58: 4520N; DIL16
IC59: 4011UB; DIL14
IC60: 4013N; DIL14
IC61: 4040N; DIL16
IC62: 27C256P; DIL28-6
IC63: 74HC174; DIL16
J3: 22-27-2041-04; 6410-04
Q70: 2SA798; SIP-5
Q71, Q75, Q76: 2SC2603; TO92-ECB
R189: 100K; 0207/7
R425: 47K; 0207/7
R426: 4.7K; 0207/7
R427, R430: 2.2K; 0207/7
R428: 220R; 0207/7
R429: 100R; 0207/7
R431: 22R; 0207/7
R432: 270K; 0207/7
R442, R458, R460: 10K; 0207/7
R443: 6.8K; 0207/7
R445: 22K; 0207/7
R456, R457, R459, R461: 5.6K; 0207/7
RA10A, RA11A: 5K; 0207/7
RA10B, RA11B: 10K; 0207/7
RA10C, RA11C: 20K; 0207/7
RA10D, RA11D: 40K; 0207/7
RA10E, RA11E: 80K; 0207/7
RA10F, RA11F: 160K; 0207/7
VR24: 50KB; EVUF
VR25: 10KB; EVUF

Connections:
+5V: C87.+, IC52.5 (+IN), IC59.14 (VDD), IC60.14 (VDD), IC61.16 (VDD), IC62.1 (VPP), IC62.28 (VCC), IC63.1 (RES), IC63.16 (VDD), R428.2, R429.2; also elsewhere on the board
+VRI: C60.+, IC65.8 (V+), Q75.C, Q76.C; also elsewhere on the board
-VRI: C86.-, IC65.4 (V-), R458.2, R460.2; also elsewhere on the board
ACCENT_CRASH: R426.1; also elsewhere on the board
CRASH_OUT: IC65.1 (OUT), J3.2, VR24.2 (S), VR24.3 (E)
GND: C60.-, C86.+, C87.-, C137.1, C139.- (2), IC51.5 (+IN), IC58.1 (CLK), IC59.7 (VSS), IC60.6 (S), IC60.7 (VSS), IC60.8 (S), IC61.8 (VSS), IC62.14 (GND), IC63.8 (VSS), IC65.3 (+IN), R189.2, R431.1, VR24.M1, VR25.M1; also elsewhere on the board
HT_OUT2: IC59.6 (I1), IC59.10 (O), IC60.11 (CLK), VR25.1 (A), VR25.2 (S)
unnamed: Q70.3 (E), R430.1
unnamed: R443.1, VR25.3 (E)
unnamed: IC59.8 (I0), IC59.9 (I1), R442.2
unnamed: C131.+ (1), R442.1, R443.2
unnamed: IC59.5 (I0), IC59.11 (O), R427.1
unnamed: C131.- (2), IC59.4 (O), IC60.3 (CLK)
unnamed: IC60.9 (D), IC60.12 (!Q)
unnamed: IC60.2 (!Q), IC60.5 (D), IC62.22 (!OE)
unnamed: IC59.1 (I0), IC60.13 (Q)
unnamed: IC59.3 (O), IC63.9 (CLK)
unnamed: IC59.2 (I1), IC60.1 (Q), IC61.10 (P1)
unnamed: IC62.19 (D7), IC63.3 (D0)
unnamed: IC62.18 (D6), IC63.4 (D1)
unnamed: IC62.17 (D5), IC63.6 (D2)
unnamed: IC62.16 (D4), IC63.11 (D3)
unnamed: IC62.15 (D3), IC63.13 (D4)
unnamed: IC62.13 (D2), IC63.14 (D5)
unnamed: C127.+, RA10A.2, RA10B.2, RA10C.2, RA10D.2, RA10E.2, RA10F.2
unnamed: R432.1, RA11A.2, RA11B.2, RA11C.2, RA11D.2, RA11E.2, RA11F.2
unnamed: C126.1, IC52.6 (-IN), Q70.2 (C1), R432.2
unnamed: C126.2, IC52.7 (OUT), R430.2
unnamed: Q70.5 (B2), R429.1
unnamed: C127.-, Q71.C, R431.2
unnamed: Q70.1 (B1), R426.2, R427.2, R428.1
unnamed: Q70.4 (C2), Q71.B
unnamed: C138.2, R459.1, R461.2
unnamed: C136.2, R456.1, R457.2
unnamed: C137.2, Q75.B, R457.1
unnamed: C139.+ (1), Q76.B, R461.1
unnamed: IC51.6 (-IN), Q71.E, R425.2
unnamed: IC51.7 (OUT), R425.1, R456.2
unnamed: C136.1, Q75.E, R458.1, R459.2
unnamed: C132.-, C138.1, Q76.E, R460.1
unnamed: IC65.2 (-IN), R445.1, VR24.1 (A)
unnamed: C132.+, R445.2
unnamed: IC58.2 (EN), IC61.1 (Q12), IC62.23 (A11), RA11D.1
unnamed: IC61.2 (Q6), IC62.5 (A5)
unnamed: IC61.3 (Q5), IC62.6 (A4)
unnamed: IC61.4 (Q7), IC62.4 (A6)
unnamed: IC61.5 (Q4), IC62.7 (A3)
unnamed: IC61.6 (Q3), IC62.8 (A2)
unnamed: IC61.7 (Q2), IC62.9 (A1)
unnamed: IC61.9 (Q1), IC62.10 (A0)
unnamed: IC61.12 (Q9), IC62.25 (A8)
unnamed: IC61.13 (Q8), IC62.3 (A7)
unnamed: IC61.14 (Q10), IC62.24 (A9), RA11F.1
unnamed: IC61.15 (Q11), IC62.21 (A10), RA11E.1
unnamed: IC58.3 (Q0), IC62.2 (A12), RA11C.1
unnamed: IC58.4 (Q1), IC62.26 (A13), RA11B.1
unnamed: IC58.5 (Q2), IC62.27 (A14), RA11A.1
unnamed: IC58.6 (Q3), IC59.12 (I0), IC59.13 (I1), IC62.20 (!CE)
unnamed: IC63.2 (Q0), RA10A.1
unnamed: IC63.5 (Q1), RA10B.1
unnamed: IC63.7 (Q2), RA10C.1
unnamed: IC63.10 (Q3), RA10D.1
unnamed: IC63.12 (Q4), RA10E.1
unnamed: C50.2, IC58.7 (RES), IC60.4 (R), IC60.10 (R), IC61.11 (RES), R189.1
unnamed: IC63.15 (Q5), RA10F.1
TRIG_CRASH: C50.1; also elsewhere on the board

Notes on the sheet:
Crash

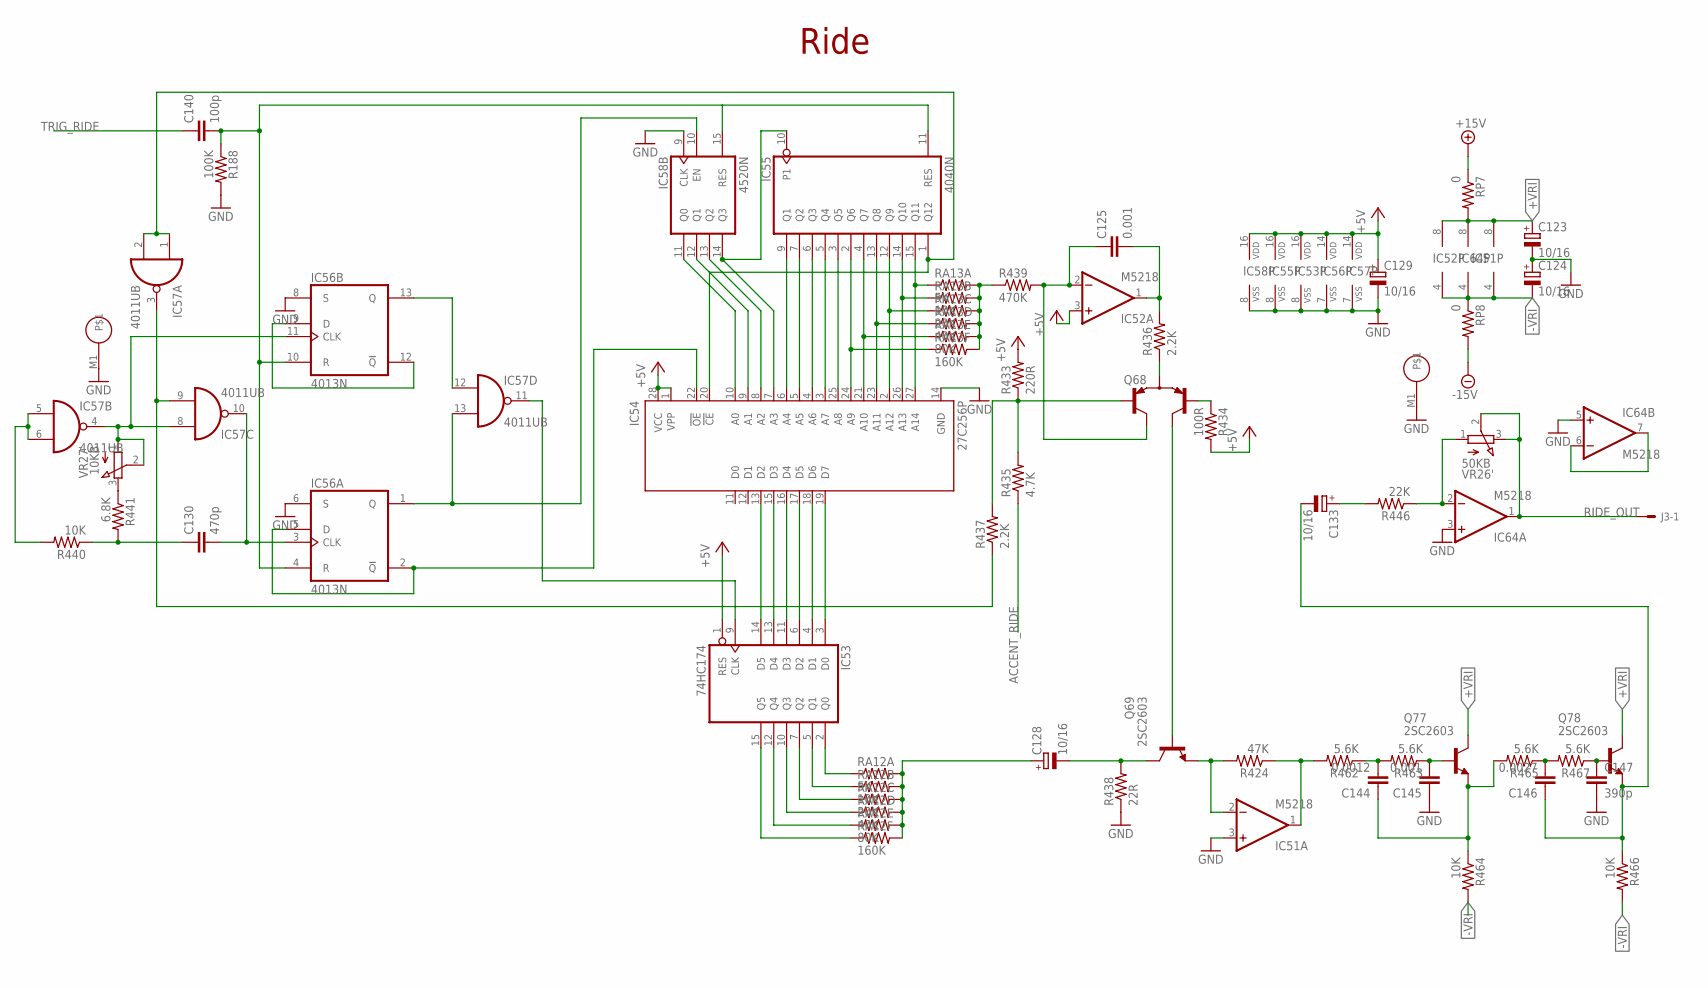
[picture p11: schematic Nava_v1.02.sch, sheet 11, RIDE]

Parts:
C123, C124, C128, C129, C133: 10/16; E2-5
C125, C145: 0.001; C050-025X075
C130: 470p; C025_RE
C140: 100p; C050-025X075
C144: 0.0012; C050-025X075
C146: 0.0027; C050-025X075
C147: 390p; C025_RE
IC51, IC52, IC64: M5218; SIL8
IC53: 74HC174; DIL16
IC54: 27C256P; DIL28-6
IC55: 4040N; DIL16
IC56: 4013N; DIL14
IC57: 4011UB; DIL14
IC58: 4520N; DIL16
J3: 22-27-2041-04; 6410-04
Q68: 2SA798; SIP-5
Q69, Q77, Q78: 2SC2603; TO92-ECB
R188: 100K; 0207/7
R424: 47K; 0207/7
R433: 220R; 0207/7
R434: 100R; 0207/7
R435: 4.7K; 0207/7
R436, R437: 2.2K; 0207/7
R438: 22R; 0207/7
R439: 470K; 0207/7
R440, R464, R466: 10K; 0207/7
R441: 6.8K; 0207/7
R446: 22K; 0207/7
R462, R463, R465, R467: 5.6K; 0207/7
RA12A, RA13A: 5K; 0207/7
RA12B, RA13B: 10K; 0207/7
RA12C, RA13C: 20K; 0207/7
RA12D, RA13D: 40K; 0207/7
RA12E, RA13E: 80K; 0207/7
RA12F, RA13F: 160K; 0207/7
RP7, RP8: 0; 0207/7
VR26: 50KB; EVUF
VR27: 10KB; EVUF

Connections:
+5V: C129.+, IC52.3 (+IN), IC53.1 (RES), IC53.16 (VDD), IC54.1 (VPP), IC54.28 (VCC), IC55.16 (VDD), IC56.14 (VDD), IC57.14 (VDD), IC58.16 (VDD), R433.2, R434.2; also elsewhere on the board
+15V: RP7.1; also elsewhere on the board
+VRI: C123.+, IC51.8 (V+), IC52.8 (V+), IC64.8 (V+), Q77.C, Q78.C, RP7.2; also elsewhere on the board
-15V: RP8.2; also elsewhere on the board
-VRI: C124.-, IC51.4 (V-), IC52.4 (V-), IC64.4 (V-), R464.2, R466.2, RP8.1; also elsewhere on the board
ACCENT_RIDE: R435.1; also elsewhere on the board
GND: C123.-, C124.+, C129.-, C145.1, C147.- (2), IC51.3 (+IN), IC53.8 (VSS), IC54.14 (GND), IC55.8 (VSS), IC56.6 (S), IC56.7 (VSS), IC56.8 (S), IC57.7 (VSS), IC58.8 (VSS), IC58.9 (CLK), IC64.3 (+IN), IC64.5 (+IN), R188.2, R438.1, VR26.M1, VR27.M1; also elsewhere on the board
HT_OUT1: IC56.11 (CLK), IC57.4 (O), IC57.8 (I0), VR27.1 (A), VR27.2 (S)
unnamed: Q68.3 (E), R436.1
unnamed: IC56.1 (Q), IC57.13 (I1), IC58.10 (EN)
unnamed: IC53.3 (D0), IC54.19 (D7)
unnamed: IC53.4 (D1), IC54.18 (D6)
unnamed: IC53.6 (D2), IC54.17 (D5)
unnamed: IC53.11 (D3), IC54.16 (D4)
unnamed: IC53.13 (D4), IC54.15 (D3)
unnamed: IC53.14 (D5), IC54.13 (D2)
unnamed: IC54.24 (A9), IC55.2 (Q6), RA13F.1
unnamed: IC54.25 (A8), IC55.3 (Q5)
unnamed: IC54.21 (A10), IC55.4 (Q7), RA13E.1
unnamed: IC54.3 (A7), IC55.5 (Q4)
unnamed: IC54.4 (A6), IC55.6 (Q3)
unnamed: IC54.5 (A5), IC55.7 (Q2)
unnamed: IC54.6 (A4), IC55.9 (Q1)
unnamed: IC54.2 (A12), IC55.12 (Q9), RA13C.1
unnamed: IC54.23 (A11), IC55.13 (Q8), RA13D.1
unnamed: IC54.26 (A13), IC55.14 (Q10), RA13B.1
unnamed: IC54.27 (A14), IC55.15 (Q11), RA13A.1
unnamed: IC54.10 (A0), IC58.11 (Q0)
unnamed: IC54.9 (A1), IC58.12 (Q1)
unnamed: IC57.5 (I0), IC57.6 (I1), R440.2
unnamed: IC54.8 (A2), IC58.13 (Q2)
unnamed: C130.+ (1), R440.1, R441.2
unnamed: IC57.3 (O), IC57.9 (I1), R437.1
unnamed: C130.- (2), IC56.3 (CLK), IC57.10 (O)
unnamed: IC54.20 (!CE), IC55.1 (Q12), IC57.1 (I0), IC57.2 (I1)
unnamed: IC53.2 (Q0), RA12A.1
unnamed: C146.2, R465.1, R467.2
unnamed: IC56.9 (D), IC56.12 (!Q)
unnamed: IC54.22 (!OE), IC56.2 (!Q), IC56.5 (D)
unnamed: IC56.13 (Q), IC57.12 (I0)
unnamed: IC53.5 (Q1), RA12B.1
unnamed: IC53.7 (Q2), RA12C.1
unnamed: IC53.9 (CLK), IC57.11 (O)
unnamed: IC53.10 (Q3), RA12D.1
unnamed: IC53.12 (Q4), RA12E.1
unnamed: IC53.15 (Q5), RA12F.1
unnamed: C128.+, RA12A.2, RA12B.2, RA12C.2, RA12D.2, RA12E.2, RA12F.2
unnamed: R439.1, RA13A.2, RA13B.2, RA13C.2, RA13D.2, RA13E.2, RA13F.2
unnamed: C125.1, IC52.2 (-IN), Q68.2 (C1), R439.2
unnamed: C125.2, IC52.1 (OUT), R436.2
unnamed: Q68.5 (B2), R434.1
unnamed: Q68.4 (C2), Q69.B
unnamed: C128.-, Q69.C, R438.2
unnamed: Q68.1 (B1), R433.1, R435.2, R437.2
unnamed: C144.2, R462.1, R463.2
unnamed: C145.2, Q77.B, R463.1
unnamed: C147.+ (1), Q78.B, R467.1
unnamed: IC51.2 (-IN), Q69.E, R424.2
unnamed: IC51.1 (OUT), R424.1, R462.2
unnamed: C144.1, Q77.E, R464.1, R465.2
unnamed: C133.+, R446.2
unnamed: C133.-, C146.1, Q78.E, R466.1
unnamed: IC64.2 (-IN), R446.1, VR26.1 (A)
unnamed: IC54.7 (A3), IC55.10 (P1), IC58.14 (Q3)
unnamed: C140.2, IC55.11 (RES), IC56.4 (R), IC56.10 (R), IC58.15 (RES), R188.1
unnamed: IC64.6 (-IN), IC64.7 (OUT)
unnamed: R441.1, VR27.3 (E)
RIDE_OUT: IC64.1 (OUT), J3.1, VR26.2 (S), VR26.3 (E)
TRIG_RIDE: C140.1; also elsewhere on the board

Notes on the sheet:
Ride

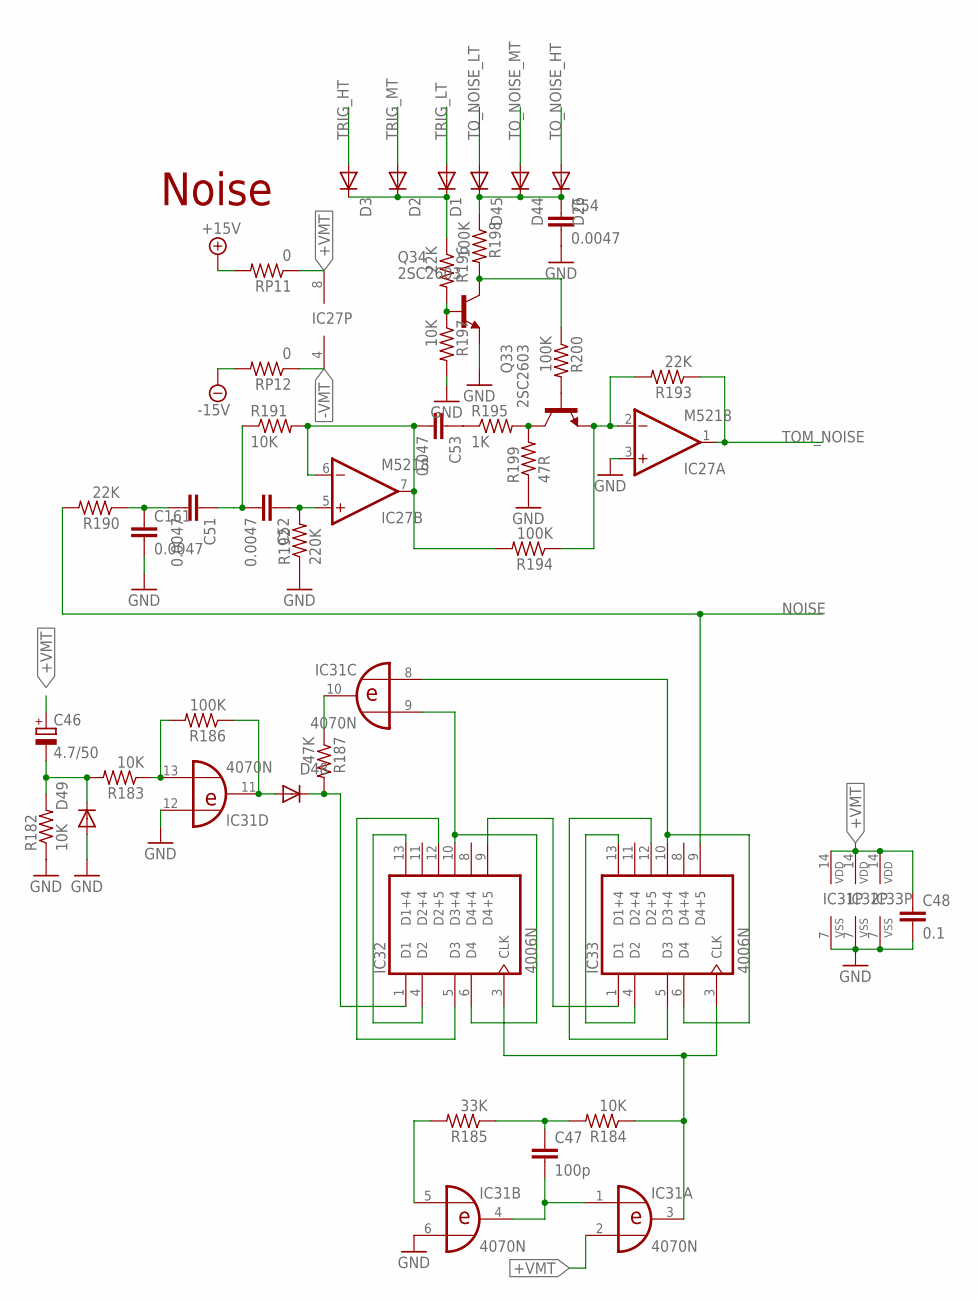
[picture p12: schematic Nava_v1.02.sch, sheet 12, NOISE]

Parts:
C46: 4.7/50; E2-5
C47: 100p; C050-025X075
C48: 0.1; C050-024X044
C51, C52, C54, C161: 0.0047; C050-025X075
C53: 0.047; C050-025X075
D1, D2, D3, D26, D44, D45, D48, D49: 1N4148"; DO35-7C
IC27: M5218; SIL8
IC31: 4070N; DIL14
IC32, IC33: 4006N; DIL14
Q33, Q34: 2SC2603; TO92-ECB
R182, R183, R184, R191, R197: 10K; 0207/7
R185: 33K; 0207/7
R186, R194, R198, R200: 100K; 0207/7
R187: 47K; 0207/7
R190, R193, R196: 22K; 0207/7
R192: 220K; 0207/7
R195: 1K; 0207/7
R199: 47R; 0207/7
RP11, RP12: 0; 0207/7

Connections:
+15V: RP11.2; also elsewhere on the board
+VMT: C46.+, C48.1, IC27.8 (V+), IC31.2 (I1), IC31.14 (VDD), IC32.14 (VDD), IC33.14 (VDD), RP11.1; also elsewhere on the board
-15V: RP12.2; also elsewhere on the board
-VMT: IC27.4 (V-), RP12.1; also elsewhere on the board
GND: C48.2, C54.2, C161.2, D49.A, IC27.3 (+IN), IC31.6 (I1), IC31.7 (VSS), IC31.12 (I0), IC32.7 (VSS), IC33.7 (VSS), Q34.E, R182.1, R192.1, R197.2, R199.1; also elsewhere on the board
unnamed: C51.2, C161.1, R190.1
unnamed: C51.1, C52.2, R191.1
unnamed: C52.1, IC27.5 (+IN), R192.2
unnamed: C53.2, IC27.6 (-IN), IC27.7 (OUT), R191.2, R194.2
unnamed: C53.1, R195.1
unnamed: Q33.C, R195.2, R199.2
unnamed: IC27.2 (-IN), Q33.E, R193.2, R194.1
unnamed: Q33.B, R200.2
unnamed: Q34.B, R196.2, R197.1
unnamed: Q34.C, R198.2, R200.1
unnamed: IC32.4 (D2), IC32.13 (D1+4)
unnamed: D1.C, D2.C, D3.C, R196.1
unnamed: C54.1, D26.C, D44.C, D45.C, R198.1
unnamed: C46.-, D49.C, R182.2, R183.2
unnamed: IC31.13 (I1), R183.1, R186.2
unnamed: D48.A, IC31.11 (O), R186.1
unnamed: IC31.10 (O), R187.1
unnamed: IC33.4 (D2), IC33.13 (D1+4)
unnamed: IC31.9 (I1), IC32.6 (D4), IC32.10 (D3+4)
unnamed: IC32.5 (D3), IC32.12 (D2+5)
unnamed: D48.C, IC32.1 (D1), R187.2
unnamed: IC31.8 (I0), IC33.6 (D4), IC33.10 (D3+4)
unnamed: IC33.5 (D3), IC33.12 (D2+5)
unnamed: IC32.9 (D4+5), IC33.1 (D1)
unnamed: IC31.5 (I0), R185.2
unnamed: C47.1, R184.2, R185.1
unnamed: C47.2, IC31.1 (I0), IC31.4 (O)
unnamed: IC31.3 (O), IC32.3 (CLK), IC33.3 (CLK), R184.1
NOISE: IC33.9 (D4+5), R190.2; also elsewhere on the board
TOM_NOISE: IC27.1 (OUT), R193.1; also elsewhere on the board
TO_NOISE_HT: D26.A; also elsewhere on the board
TO_NOISE_LT: D45.A; also elsewhere on the board
TO_NOISE_MT: D44.A; also elsewhere on the board
TRIG_HT: D3.A; also elsewhere on the board
TRIG_LT: D1.A; also elsewhere on the board
TRIG_MT: D2.A; also elsewhere on the board

Notes on the sheet:
Noise

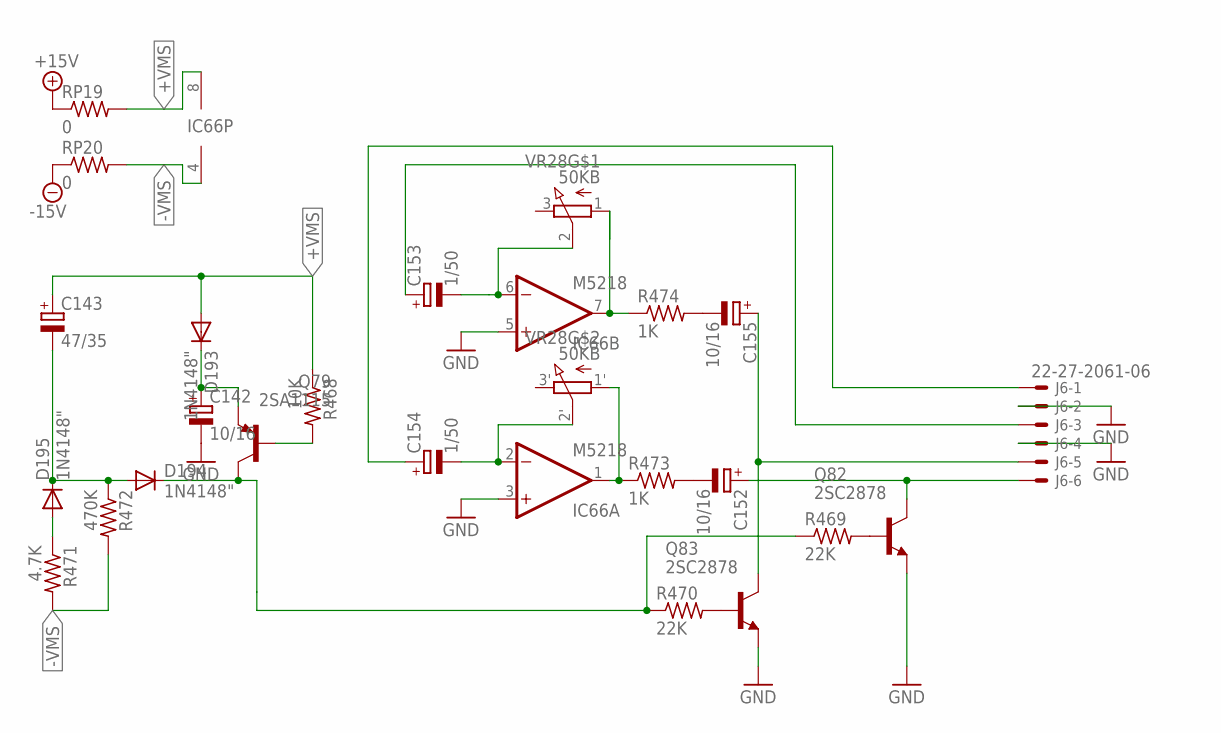
[picture p13: schematic Nava_v1.02.sch, sheet 13, Master]

Parts:
C142, C152, C155: 10/16; E2-5
C143: 47/35; E2,5-6
C153, C154: 1/50; E2-5
D193, D194, D195: 1N4148"; DO35-7C
IC66: M5218; SIL8
J6: 22-27-2061-06; 6410-06
Q79: 2SA1115; TO92-ECB-PNP
Q82, Q83: 2SC2878; TO92-ECB
R468: 10K; 0207/7
R469, R470: 22K; 0207/7
R471: 4.7K; 0207/7
R472: 470K; 0207/7
R473, R474: 1K; 0207/7
RP19, RP20: 0; 0207/7
VR28: 50KB; PTV112-4

Connections:
+15V: RP19.1; also elsewhere on the board
+VMS: C143.+, D193.A, IC66.8 (V+), R468.1, RP19.2
-15V: RP20.1; also elsewhere on the board
-VMS: IC66.4 (V-), R471.2, R472.2, RP20.2
GND: C142.-, IC66.3 (+IN), IC66.5 (+IN), J6.2, J6.4, Q82.E, Q83.E; also elsewhere on the board
unnamed: D195.A, R471.1
unnamed: C143.-, D194.A, D195.C, R472.1
unnamed: IC66.7 (OUT), R474.1, VR28.1
unnamed: IC66.1 (OUT), R473.1, VR28.1' (1)
unnamed: D194.C, Q79.C, R469.1, R470.1
unnamed: C142.+, D193.C, Q79.E
unnamed: Q79.B, R468.2
unnamed: C154.-, IC66.2 (-IN), VR28.2' (2)
unnamed: C153.-, IC66.6 (-IN), VR28.2
unnamed: C155.-, R474.2
unnamed: C152.-, R473.2
unnamed: Q82.B, R469.2
unnamed: Q83.B, R470.2
unnamed: C153.+, J6.3
unnamed: C155.+, J6.5, Q83.C
unnamed: C152.+, J6.6, Q82.C
unnamed: C154.+, J6.1

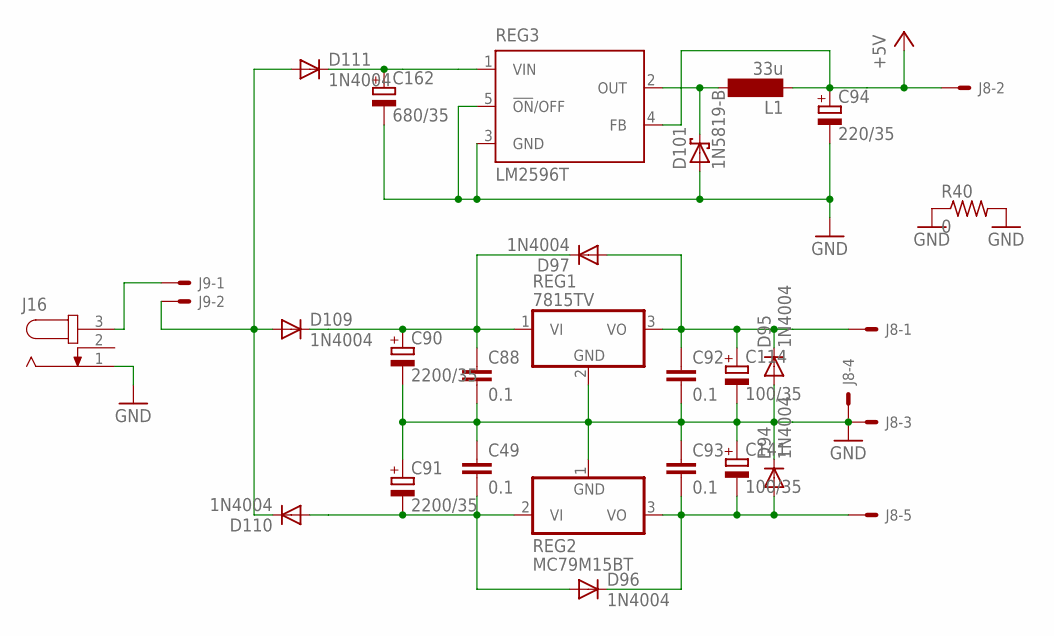
[picture p14: schematic Nava_v1.02.sch, sheet 14, PSU]

Parts:
C49, C88, C92, C93: 0.1; C050-024X044
C90, C91: 2200/35; E7,5-16
C94: 220/35; E3,5-8
C114, C141: 100/35; E3,5-8
C162: 680/35; E5-13
D94, D95, D96, D97, D109, D110, D111: 1N4004; DO41-7
D101: 1N5819-B; DO41-7.6
J8: KK-156-5
J9: KK-156-2
J16: JACK-PLUG0; JACK_PSU_2.1MM
L1: 33u; BS11
R40: 0; 0207/7
REG1: 7815TV; TO220V
REG2: MC79M15BT; TO220V
REG3: LM2596T; T05D

Connections:
+5V: C94.+, J8.2, L1.1, REG3.4 (FB); also elsewhere on the board
GND: C49.1, C88.2, C90.-, C91.+, C92.2, C93.1, C94.-, C114.-, C141.+, C162.-, D94.C, D95.A, D101.A, J8.3, J8.4, J16.1, R40.1, R40.2, REG1.2 (GND), REG2.1 (GND), REG3.3 (GND), REG3.5 (!ON!/OFF); also elsewhere on the board
unnamed: C49.2, C91.-, D96.A, D110.A, REG2.2 (VI)
unnamed: C88.1, C90.+, D97.C, D109.C, REG1.1 (VI)
unnamed: C92.1, C114.+, D95.C, D97.A, J8.1, REG1.3 (VO)
unnamed: D109.A, D110.C, D111.A, J9.2
unnamed: C93.2, C141.-, D94.A, D96.C, J8.5, REG2.3 (VO)
unnamed: C162.+, D111.C, REG3.1 (VIN)
unnamed: D101.C, L1.2, REG3.2 (OUT)
unnamed: J9.1, J16.3

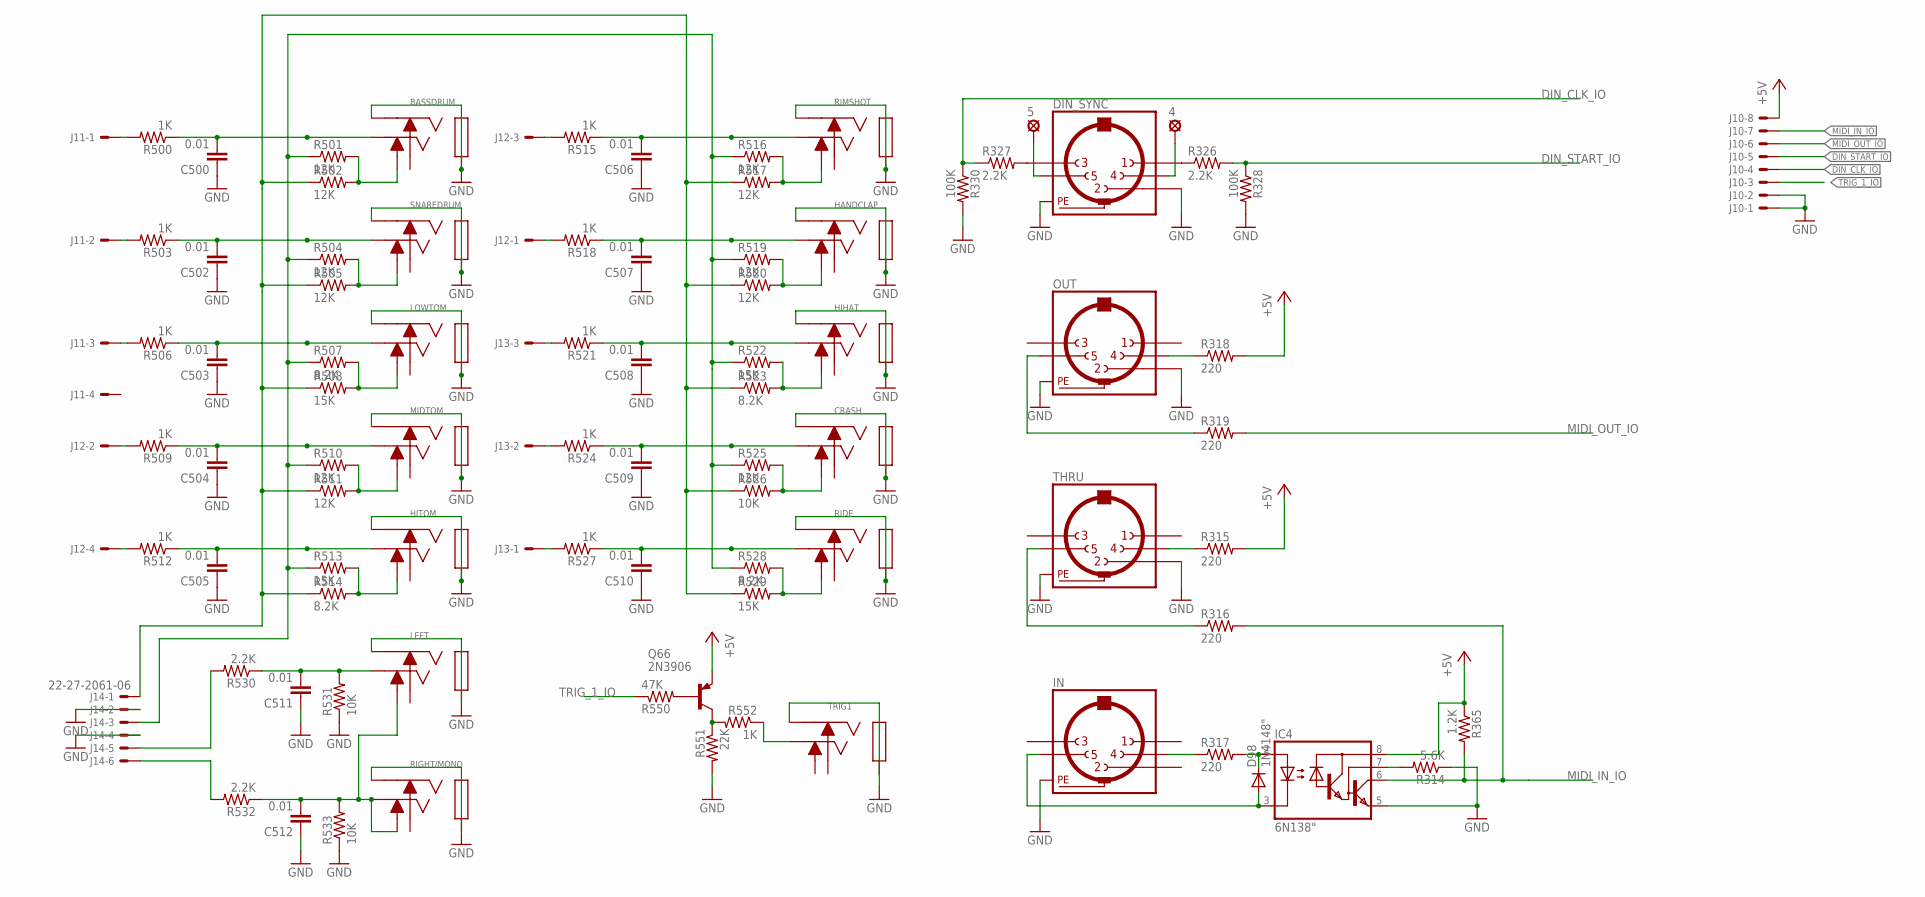
[picture p15: schematic Nava_v1.02.sch, sheet 15, IO]

Parts:
4, 5: LSP10
BASSDRUM: JACK_TRSNRJ6HF; JACK_TRS
C500, C502, C503, C504, C505, C506, C507, C508, C509, C510, C511, C512: 0.01; C050-025X075
CRASH: JACK_TRSNRJ6HF; JACK_TRS
D98: 1N4148"; DO35-7C
DIN_SYNC: MAB5SH
HANDCLAP: JACK_TRSNRJ6HF; JACK_TRS
HIHAT: JACK_TRSNRJ6HF; JACK_TRS
HITOM: JACK_TRSNRJ6HF; JACK_TRS
IC4: 6N138"; DIL08
IN: MAB5SH
J10: 22-27-2081-08; 6410-08
J11, J12, J13: 22-27-2041-04; 6410-04
J14: 22-27-2061-06; 6410-06
LEFT: JACK_TRSNRJ6HF; JACK_TRS
LOWTOM: JACK_TRSNRJ6HF; JACK_TRS
MIDTOM: JACK_TRSNRJ6HF; JACK_TRS
OUT: MAB5SH
Q66: 2N3906; TO92-EBC-SMALL
R314: 5.6K; 0207/7
R315, R316, R317, R318, R319: 220; 0207/7
R326, R327, R530, R532: 2.2K; 0207/7
R328, R330: 100K; 0207/7
R365: 1.2K; 0207/7
R500, R503, R506, R509, R512, R515, R518, R521, R524, R527, R552: 1K; 0207/7
R501, R502, R504, R505, R510, R511, R516, R517, R519, R520, R525: 12K; 0207/7
R507, R514, R523, R528: 8.2K; 0207/7
R508, R513, R522, R529: 15K; 0207/7
R526, R531, R533: 10K; 0207/7
R550: 47K; 0207/7
R551: 22K; 0207/7
RIDE: JACK_TRSNRJ6HF; JACK_TRS
RIGHT/MONO: JACK_TRSNRJ6HF; JACK_TRS
RIMSHOT: JACK_TRSNRJ6HF; JACK_TRS
SNAREDRUM: JACK_TRSNRJ6HF; JACK_TRS
THRU: MAB5SH
TRIG1: JACK_TRSNRJ6HF; JACK_TRS

Connections:
+5V: IC4.8 (VCC), J10.8, Q66.E, R315.2, R318.2, R365.1; also elsewhere on the board
DIN_CLK_IO: J10.4, R327.1, R330.1
DIN_START_IO: J10.5, R326.2, R328.1
GND: BASSDRUM.R, BASSDRUM.S, C500.1, C502.1, C503.1, C504.1, C505.1, C506.1, C507.1, C508.1, C509.1, C510.1, C511.1, C512.1, CRASH.R, CRASH.S, DIN_SYNC.2, DIN_SYNC.PE, DIN_SYNC.PE@ (PE), HANDCLAP.R, HANDCLAP.S, HIHAT.R, HIHAT.S, HITOM.R, HITOM.S, IC4.5 (GND), IN.PE, IN.PE@ (PE), J10.1, J10.2, J14.2, J14.4, LEFT.R, LEFT.S, LOWTOM.R, LOWTOM.S, MIDTOM.R, MIDTOM.S, OUT.2, OUT.PE, OUT.PE@ (PE), R314.1, R328.2, R330.2, R531.1, R533.1, R551.2, RIDE.R, RIDE.S, RIGHT/MONO.R, RIGHT/MONO.S, RIMSHOT.R, RIMSHOT.S, SNAREDRUM.R, SNAREDRUM.S, THRU.2, THRU.PE, THRU.PE@ (PE), TRIG1.R, TRIG1.S; also elsewhere on the board
MIDI_IN_IO: IC4.6 (VO), J10.7, R316.2, R365.2
MIDI_OUT_IO: J10.6, R319.2
unnamed: R552.1, TRIG1.T
unnamed: 5.MP, DIN_SYNC.5
unnamed: 4.MP, DIN_SYNC.4
unnamed: BASSDRUM.TN, R501.2, R502.2
unnamed: BASSDRUM.T, C500.2, R500.1
unnamed: Q66.B, R550.2
unnamed: J11.1, R500.2
unnamed: C512.2, LEFT.TN, R532.1, R533.2, RIGHT/MONO.T, RIGHT/MONO.TN
unnamed: R504.2, R505.2, SNAREDRUM.TN
unnamed: C502.2, R503.1, SNAREDRUM.T
unnamed: J11.2, R503.2
unnamed: C511.2, LEFT.T, R530.1, R531.2
unnamed: LOWTOM.TN, R507.2, R508.2
unnamed: C503.2, LOWTOM.T, R506.1
unnamed: J11.3, R506.2
unnamed: J12.1, R518.2
unnamed: MIDTOM.TN, R510.2, R511.2
unnamed: C504.2, MIDTOM.T, R509.1
unnamed: J12.2, R509.2
unnamed: J12.3, R515.2
unnamed: HITOM.TN, R513.2, R514.2
unnamed: C505.2, HITOM.T, R512.1
unnamed: J14.1, R502.1, R505.1, R508.1, R511.1, R514.1, R517.1, R520.1, R523.1, R526.1, R529.1
unnamed: J12.4, R512.2
unnamed: R516.2, R517.2, RIMSHOT.TN
unnamed: C506.2, R515.1, RIMSHOT.T
unnamed: J13.1, R527.2
unnamed: J13.2, R524.2
unnamed: HANDCLAP.TN, R519.2, R520.2
unnamed: IN.4, R317.1
unnamed: D98.C, IC4.2 (A), R317.2
unnamed: D98.A, IC4.3 (C), IN.5
unnamed: R315.1, THRU.4
unnamed: R316.1, THRU.5
unnamed: IC4.7 (VB), R314.2
unnamed: OUT.4, R318.1
unnamed: OUT.5, R319.1
unnamed: DIN_SYNC.1, R326.1
unnamed: DIN_SYNC.3, R327.2
unnamed: C507.2, HANDCLAP.T, R518.1
unnamed: Q66.C, R551.1, R552.2
unnamed: J13.3, R521.2
unnamed: HIHAT.TN, R522.2, R523.2
unnamed: C508.2, HIHAT.T, R521.1
unnamed: J14.5, R530.2
unnamed: J14.6, R532.2
unnamed: CRASH.TN, R525.2, R526.2
unnamed: C509.2, CRASH.T, R524.1
unnamed: R528.2, R529.2, RIDE.TN
unnamed: C510.2, R527.1, RIDE.T
unnamed: J14.3, R501.1, R504.1, R507.1, R510.1, R513.1, R516.1, R519.1, R522.1, R525.1, R528.1
TRIG_1_IO: J10.3, R550.1
