e-licktronic/Nava-v1.0/Eagle/Nava_v1.02.brd

## EAGLE design Eagle/Nava_v1.02.brd (continued)

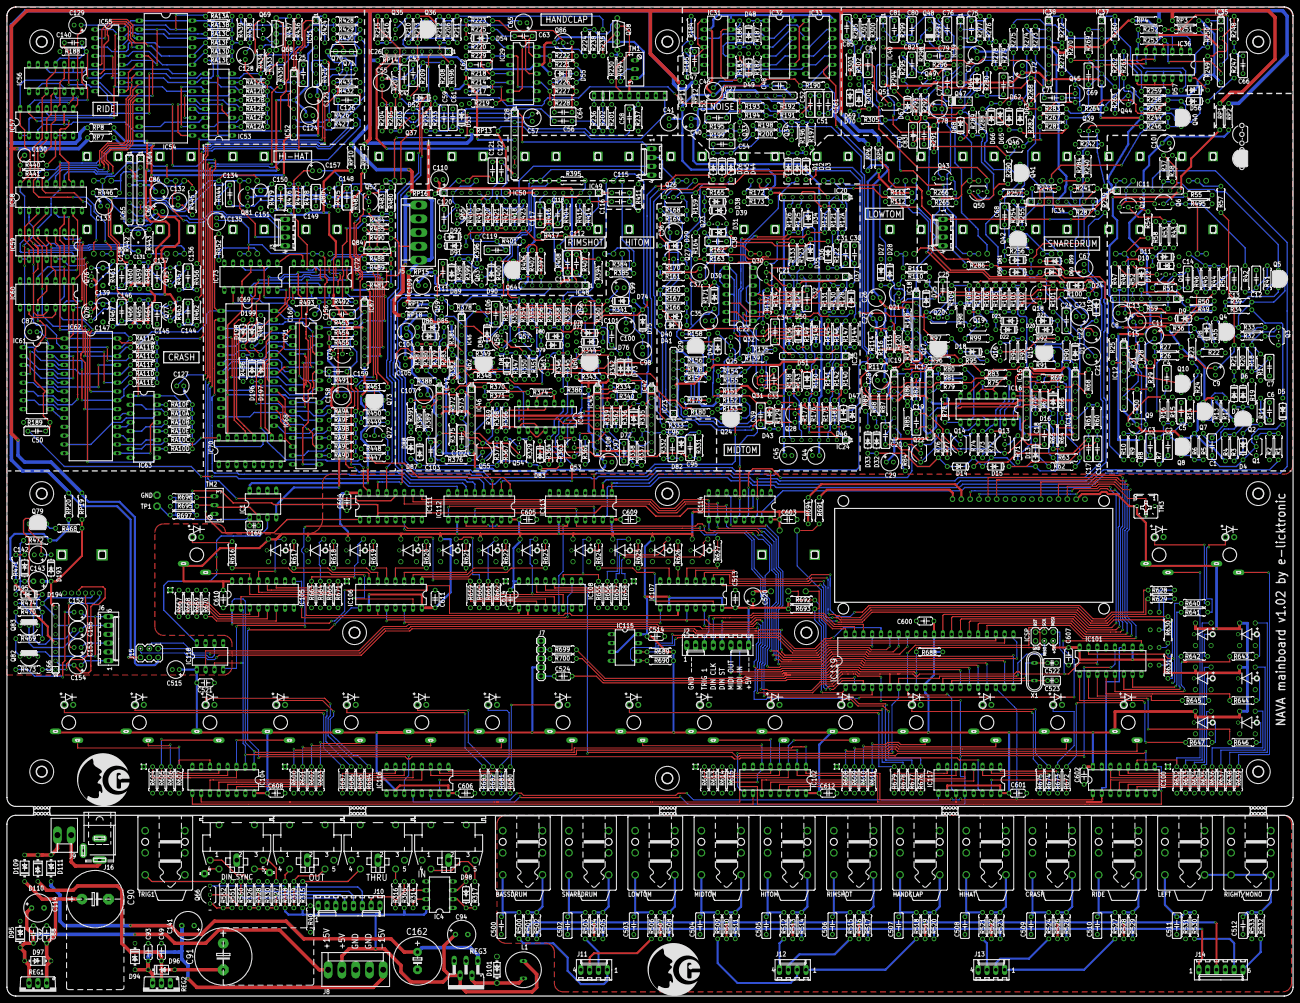
[picture p16: board Nava_v1.02.brd from above]

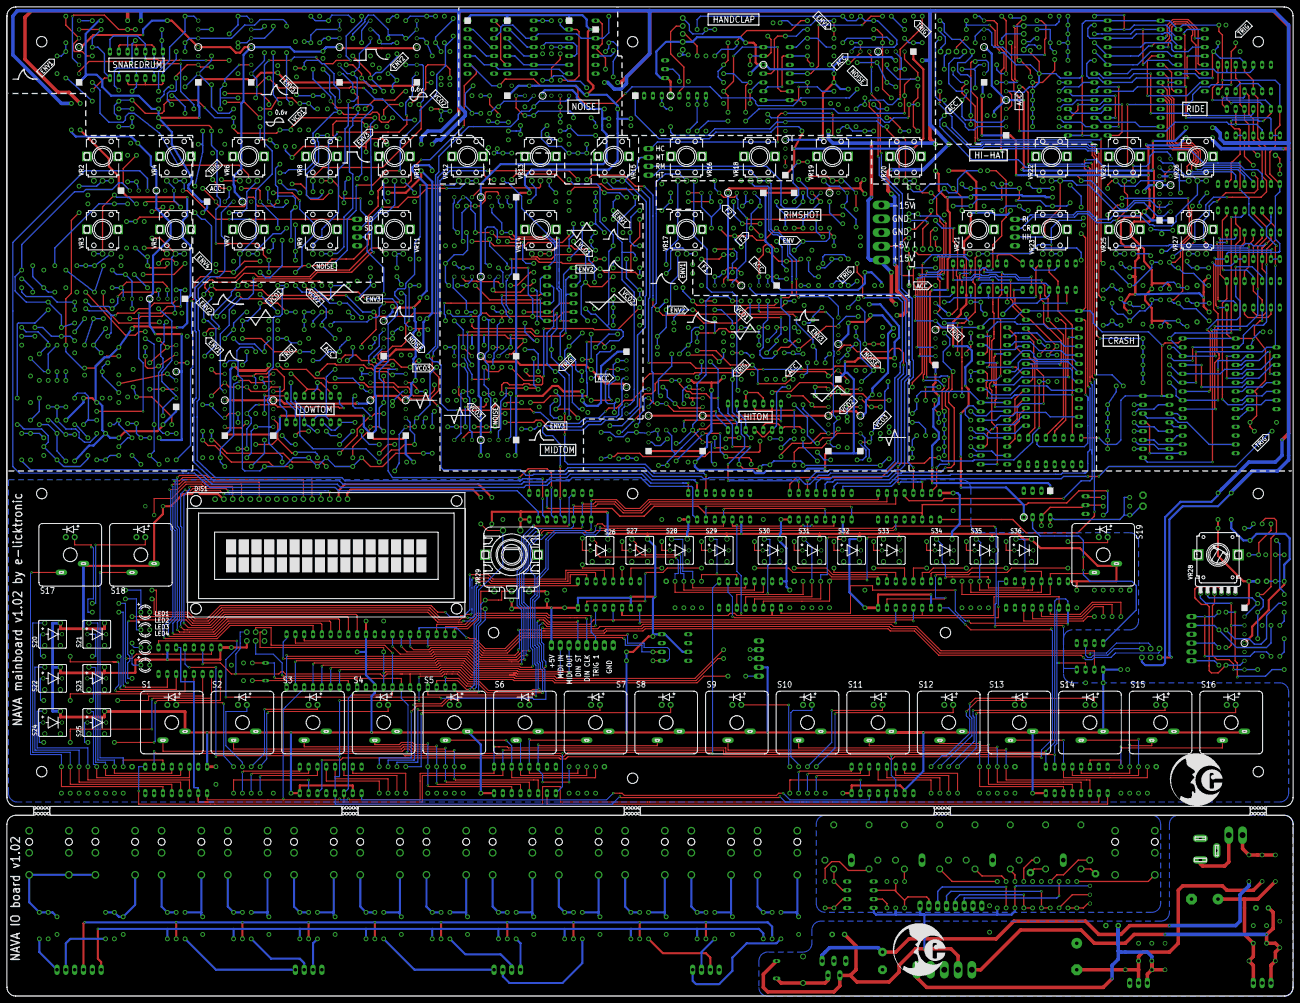
[picture p17: board Nava_v1.02.brd from below]

Board: 2 copper layers, 370.0 x 284.6 mm, 1261 parts (71 on the bottom side), 939 nets.

Other parts of the board:
U$1, U$13, U$14, U$15: LOGO_15MM_LITE
U$2, U$3, U$4, U$5, U$6, U$7, U$8, U$9, U$10, U$11, U$12: 3,0
U$16: TO92-EBC-NPN-SYM
U$17: TO92-EBC-PNP-SYM
