e-licktronic/Nava-v1.0/Nava_v1_028beta/define.h

#define define_h
#define DEBUG 0
  #if DEBUG
   unsigned int stepValue_old = 0;
   byte ppqn_old = 14;
  #endif
#define NOTE_ON_CMD 0x90
#define NOTE_OFF_CMD 0x80
#define CLOCK_CMD 0xF8
#define START_CMD 0xFA
#define STOP_CMD 0xFC
#define ALL_NOTE_OFF 0x7B
#define CONTINU_CMD 0xFB
#define MIDI_BAUD 31250
#define BTN_PLAY     B10000000
#define BTN_STOP     B1
#define BTN_LASTSTEP B1000000
#define BTN_SCALE    B10
#define BTN_SHUF     B100000
#define BTN_CLEAR    B100
#define BTN_INST     B10000
#define BTN_SHIFT    B1000
#define BTN_TRK  B1000
#define BTN_BACK     B100
#define BTN_FWD      B10
#define BTN_NUM      B1
#define BTN_PTRN B10000000
#define BTN_TAP      B1000000
#define BTN_DIR      B100000
#define BTN_GUIDE    B10000
#define BTN_BANK     B1
#define BTN_MUTE     B10
#define BTN_TEMPO    B100
#define BTN_ENTER    B1000
#define BTN_ENCODER  B100
#define ENC_SW_GET   PINB & BTN_ENCODER
#define ENC_PINA    0
#define ENC_PINB    1
#define JUSTPRESSED 1
#define JUSTRELEASE 0
#define HOLD_TIME 1000 //1s to trig hold
#define NBR_BTN_STEP 16
#define LED_STOP  B1
#define LED_PLAY  B10000000
#define LED_MASK  0xDD55 //mask to fade selected inst led
#define LED_MASK_OH  0xFD55
#define MAX_CUR_POS 4
#define MAX_CONF_PAGE 2
#define TOGGLE 0
#define MOMENTARY 1
#define TRUE 1
#define FALSE 0
#define ON 1
#define OFF 0
#define BOOTLOADER_TIME 5000 // time staying in bootloader
#define NBR_INST 16
#define NBR_STEP_BTN 16
#define NBR_STEP 16
#define NBR_PATTERN 16 //Number of pattern in a bank
#define NBR_BANK 8
#define MID_VEL 40 //velocity 0 to 127
#define HIGH_VEL 80
#define MAX_VEL 127
#define MAX_SEQ_DIR 3
#define FORWARD 0
#define BACKWARD 1
#define PING_PONG 2
#define RANDOM 3
#define MAX_BANK 7 //bank A to H
#define MAX_PTRN 128
#define MAX_TRACK 16
#define MAX_PTRN_TRACK 1024
#define MIN_BPM 30
#define MAX_BPM 250
#define DEFAULT_BPM 120
#define PPQN 96
#define SCALE_16 PPQN/4           //24
#define SCALE_32 PPQN/8           //12
#define SCALE_16t PPQN/6          //16
#define SCALE_8t PPQN/3           //32
#define MAX_SHUF_TYPE 7
#define MAX_FLAM_TYPE 8                                     // [zabox] [1.027] flam
#define DEFAULT_FLAM 0                                      //
#define DEFAULT_SHUF 1
#define DEFAULT_LEN 16
#define DEFAULT_SCALE 24
#define MASTER 0
#define SLAVE 1
#define EXPANDER 2                                          // [zabox] [1.028]
#define MAX_BLOCK_LEN 16
#define POSITION 0
#define LENGTH 1
#define MAX_TOTAL_ACC 13
#define MIN_TOTAL_ACC 0
#define SYNC 1
#define FREE 0
#define MAX_OCT 8
#define DEFAULT_OCT 3 //corresponding to +0
#define MAX_EXT_INST_NOTE 99
#define TRIG_HIGH PORTA |= 1 << 2
#define TRIG_LOW  PORTA &= ~(1 << 2)
#define TRIG1_PIN 26
#define TRIG2_PIN 27
#define DIN_START_PIN 24
#define DIN_CLK_PIN 25
#define TRIG_LENGHT 10 //10ms
#define DIN_START_HIGH PORTA |= 1
#define DIN_START_LOW  PORTA &= ~(1)
#define DIN_CLK_HIGH   PORTA |= 1 << 1
#define DIN_CLK_LOW    PORTA &= ~(1 << 1)
#define SW_CS_LOW PORTD&=~(1<<4)
#define SW_CS_HIGH PORTD|=(1<<4)
#define LED_CS_LOW   PORTB&=~(1<<4)
#define LED_CS_HIGH  PORTB|=(1<<4)
#define TRIG_CS_LOW   PORTB&=~(1<<3)
#define TRIG_CS_HIGH  PORTB|=(1<<3)
#define DAC_CS_HIGH  PORTD|=(1<<5)
#define DAC_CS_LOW  PORTD &=~(1<<5)
#define DEBOUNCE_TIME 5
#define MUX_ADDR_PORT PORTA
#define NBR_MUX_OUT 5
#define NBR_MUX 2
#define MUX_INH_PORT PORTD
#define MUX_INH1_BIT 6
#define MUX_INH2_BIT 7
#define MUX_INH1_HIGH PORTD|=(1<<6)
#define MUX_INH1_LOW PORTD &=~(1<<6)
#define MUX_INH2_HIGH PORTD|=(1<<7)
#define MUX_INH2_LOW PORTD &=~(1<<7)
#define MUX_ADDR_0 PORTA &=~(1<<7)&~(1<<6)&~(1<<5)
#define MUX_ADDR_1 PORTA |=(1<<7)&~(1<<6)&~(1<<5)
#define BD_BTN 0
#define BD_LOW_BTN 1
#define SD_BTN 2
#define SD_LOW_BTN 3
#define LT_BTN 4
#define LT_LOW_BTN 5
#define MT_BTN 6
#define MT_LOW_BTN 7
#define HT_BTN 8
#define HT_LOW_BTN 9
#define RM_BTN 10
#define HC_BTN 11
#define CH_BTN 12
#define CH_LOW_BTN 13
#define CRASH_BTN 14
#define RIDE_BTN 15
#define OH_BTN 12288   //bit 13 and bit 12 of a 16bits word
#define BD_F_BTN 3     //bit 0 and bit 1 of a 16bits word                 // [zabox] [1.027] flam buttons
#define SD_F_BTN 12    //bit 2 and bit 3 of a 16bits word                 //
#define LT_F_BTN 48    //bit 4 and bit 5 of a 16bits word                 //
#define MT_F_BTN 192   //bit 6 and bit 7 of a 16bits word                 //
#define HT_F_BTN 768   //bit 8 and bit 9 of a 16bits word                 //
#define BD 8
#define SD 9
#define LT 10
#define MT 11
#define HT 2
#define RM 3
#define HC 4
#define HH 5
#define CRASH 7
#define RIDE 6
#define HH_SLCT 1
#define OH 15 //unused shift OUT
#define CH 14 //unused shift OUT
#define TRIG_OUT 0
#define TOTAL_ACC 12
#define EXT_INST 13
enum SeqMode
{
  TRACK_PLAY, TRACK_WRITE, PTRN_PLAY, PTRN_STEP, PTRN_TAP, MUTE
};
byte dinSr[5]={
  0};//Store Din value of the five shift register
byte tempDin[5][2];//Used for the bounce
unsigned long debounceTimer;
typedef struct Button Button;
struct Button
{
  boolean curState;//1 is ON, 0 is OFF
  boolean prevState;
  boolean pressed;
  boolean justPressed;
  boolean justRelease;
  boolean hold;// 1 is holding
  byte counter;//count number of push on the button
  unsigned long curTime;
};
Button stepBtn[NBR_STEP_BTN];
Button playBtn;
Button stopBtn;
Button encBtn;
Button guideBtn;
Button scaleBtn;
Button tapBtn;
Button dirBtn;
Button tempoBtn;
Button shufBtn;
Button enterBtn, numBtn, lastStepBtn, backBtn, fwdBtn, muteBtn, bankBtn, stepsBtn, ptrnBtn, trkBtn, clearBtn;
boolean instBtn;
boolean shiftBtn;
boolean doublePush = 0; //flag that CH and CH_LOW button are pressed together
byte instOut[NBR_INST]=  {
  BD, BD, SD, SD, LT, LT, MT, MT, HT, HT, RM, HC, CH, CH, CRASH, RIDE};
unsigned int readButtonState;
unsigned int muteButtons;                                                                            // [1.028]
unsigned int lastMuteButtons;                                                                        //
unsigned int gateButtons;                                                                            //
unsigned int lastGateButtons;                                                                        //
unsigned int stepLeds;
unsigned int stepLedsHigh;
unsigned int stepLedsLow;
byte menuLed;
unsigned int configLed;
volatile boolean blinkTempo = 1;
volatile boolean blinkFast = 1;
volatile boolean blinkVeryFast;
boolean stopLed;
boolean trackLed;
boolean backLed;
boolean fwdLed;
boolean numLed;
boolean ptrnLed;
boolean tapLed;
boolean dirLed;
boolean guideLed;
boolean bankLed;
boolean muteLed;
boolean tempoLed;
boolean instLed;
boolean shiftLed;
boolean clearLed;
boolean shufLed;
boolean scaleLed;
boolean lastStepLed;
byte scaleLeds;
boolean enterLed;
unsigned int instSlctLed;//[NBR_INST]={0x00, 0x00, 0x300, 0x400, 0x800,
byte ledUpdateCounter = 3;                                                                                               // [zabox] [1.028]
byte flagLedIntensity;
unsigned int muteLedsOrder[NBR_STEP_BTN]=  {
  0x03, 0x03, 0x0C, 0x0C, 0x30, 0x30, 0xC0, 0xC0, 0x300, 0x300, 0x400, 0X800, 0x1000, 0x2000, 0x4000, 0x8000};           // [zabox] update for OH/CH mute
unsigned int muteLeds = 0;
struct SeqConfig {
  boolean ptrnChangeSync;// 0 = free pattern change  1 = sync end measure pattern change
  byte sync;//0 = MASTER  1 = SLAVE   2 = EXPANDER                                                                       // [zabox] [1.028]
  boolean syncChanged;
  byte TXchannel;//MIDI transmit channel
  byte RXchannel;
  unsigned int bpm;
  unsigned int defaultBpm;// stored in the eeprom
  byte dir;
  byte configPage;
  boolean configMode;
  boolean setupNeedSaved;
  boolean muteModeHH;                 // [zabox]  HH mute mode
}
seq;
volatile byte ppqn = 0;
volatile byte curStep = 0;
volatile int stepCount = -1;
volatile byte tapStepCount;//this counter is used to get a better tap response
volatile boolean stepChanged = FALSE;
volatile byte noteIndexCpt = 0;
boolean isRunning = FALSE;
boolean isStop = TRUE;
SeqMode curSeqMode = PTRN_STEP;
SeqMode prevSeqMode;
byte curInst = BD;//8 is BD trig out shift register
byte curFlam = 0;                                                      // [zabox] [1.028] flam
byte curBank = 0;//0 to 7 banks
byte curPattern = 0;// 0 to 255
byte nextPattern;
volatile unsigned int stepValue = 0;
volatile unsigned int stepValueFlam = 0;                               // [zabox] [1.028] flam
boolean changeDir; //use to PING PONG change dir
volatile boolean endMeasure;
unsigned int metronome;//value of metronome trig
int shuffle[MAX_SHUF_TYPE][2]={
  {
    0            }
  ,{
    0,-1          }
  ,{
    0,-2          }
  ,{
    0,-3          }
  ,{
    0,-4          }
  ,{
    0,-5          }
  ,{
    0,-6          }
};
volatile boolean shufPolarity;
int flam[MAX_FLAM_TYPE] =                                               // [zabox] [1.028] flam
{ 4999, 5999, 6999, 7999, 8999, 9999, 10999, 11999 };                // flam timings from EchoBoy (in ms: 20, 24, 28, 32, 36, 40, 44, 48)
typedef struct Pattern Pattern;
struct Pattern
{
  byte length;//0 to 15 steps
  byte scale;
  byte dir;//0=>forward, 1=>backword, 2=>ping-pong, 3=>random
  byte shuffle;
  byte flam;
  unsigned int inst[NBR_INST];
  unsigned int step[NBR_STEP];
  byte velocity[NBR_INST][NBR_STEP];
  byte extNote[128];// DUE to EEPROM 64 bytes PAGE WRITE
  byte extLength;
  byte groupPos;
  byte groupLength;
  byte totalAcc;
};
Pattern pattern[2];//current pattern and next pattern in the buffer
Pattern bufferedPattern;//to copy paste pattern
boolean ptrnBuffer = 0;
boolean patternWasEdited = FALSE;
boolean selectedPatternChanged = FALSE;
boolean nextPatternReady = FALSE;
boolean patternNeedSaved = FALSE;
byte prevShuf;                                                          // [zabox] [1.028] flam
byte prevFlam;                                                          // [zabox] [1.028] flam
struct GroupPattern
{
  byte length;//length of the pattern bloc
  byte firstPattern;//first pattern of the bloc
  byte pos;
  boolean priority;//use to know if volatile group have priority on stored pattern group
}
group;
unsigned int tempInst[NBR_INST]={
  0};
unsigned int muteInst = 0;
unsigned int prev_muteInst = 0;                                                                                // [zabox]
byte muteOut[NBR_STEP_BTN]=  {
  BD, BD, SD, SD, LT, LT, MT, MT, HT, HT, RM, HC, CH, OH, CRASH, RIDE};                                        // [zabox] added CH/OH mute
volatile unsigned int tempDoutTrig;// used to know what OH or CH is trigged
volatile unsigned int lastDoutTrig;// used to know what OH or CH is trigged                                    // [zabox] [1.028] test
byte lastHHtrigged;// remmeber last OH or CH was trigged to prevent OH noise when trigget other instruments
byte instVelHigh[NBR_INST]={
  1, 1, 50, 50, 50, 108, 112, 107, 50, 50, 50, 50, 1, 1, 111, 109};
byte instVelLow[NBR_INST]={
  0, 0, 25, 25, 25, 50, 111, 106, 25, 25, 25, 25, 0, 0, 80, 108};
typedef struct Track Track;
struct Track
{
  unsigned int length;//lenght before loop 0 to 999
  byte patternNbr[MAX_PTRN_TRACK];//Should be 999
};
Track track[2];
typedef struct TrackSetup TrackSetup;
struct TrackSetup
{
  byte next;
  byte current;//number of the track 0 to 15
  unsigned int pos;//track position 0 to 999
  volatile byte indexCpt;//incrementer each pattern end
  boolean wasEdited;
};
TrackSetup trk;
boolean selectedTrackChanged = FALSE;
boolean trkBuffer = 0;
boolean trackNeedSaved = FALSE;
boolean trackJustSaved = FALSE;
volatile boolean trackPosNeedIncremante = FALSE;
unsigned long timeSinceSaved;
boolean keyboardMode;
byte keybOct = DEFAULT_OCT;
byte noteIndex = 0;//external inst note index
SPISettings SPIset(4000000, MSBFIRST, SPI_MODE0);
SPISettings SPIset_f(4000000, MSBFIRST, SPI_MODE0);                        // [zabox] ready for faster write spi (8mhz), signal integrity looks good and i haven't had any issues, but i'll keep it a 4mhz until the next update and further investigation.
byte encoder_A;
byte encoder_B;
byte encoder_A_prev=0;
boolean encSwValue[2];
boolean encSwState;
byte muxAddr[5]={
  B0, B10000000, B1000000, B11000000, B100000};// Due to the  A, B, C pin on muxiPORTA sequence
byte muxInst[10]={
  LT, SD, BD, MT, HT, HC, RM, CH, CRASH, RIDE};//To match with DAC mux OUT
boolean needLcdUpdate = TRUE;
byte curIndex;//position of the cursor
byte curPage = 0;
byte cursorPos[MAX_CUR_POS]={
  0, 4, 8, 12};
const char *letterUpTrackWrite[MAX_CUR_POS]={
  "P", "P", "L", "N"};
const char *letterUpExtInst[MAX_CUR_POS]={
  "I", "N", "L", "O"};
const char *letterUpConfPage1[MAX_CUR_POS]={
  "S", "B", "M", "M"};
const char *letterUpConfPage2[MAX_CUR_POS]={                          // [zabox] N to M for mute mode
  "P", "M", "N", "N"};
volatile boolean midiNoteOnActive = FALSE;
boolean midiStart;
boolean midiStop;
boolean midiContinue;
boolean instWasMidiTrigged[NBR_INST] ={
  FALSE};
byte midiVelocity[NBR_INST]={
  100};
boolean dinStartState = LOW;
boolean dinClkState = LOW;
unsigned long bootElapseTime = 0;
byte btnPlayStopByte = 0;
byte btnEnterByte = 0;
volatile boolean trigCounterStart = FALSE;
#define TRIG_TIMER_STOP  TCCR2B = 0                                         // Stop timer2 (trigger)
#define TRIG_TIMER_START TCCR2B = _BV(CS22) | _BV(CS20)                     // Set prescaler to 128 and start the timer
#define TRIG_TIMER_ZERO  TCNT2  = 0                                         // reset timer
#define FLAM_TIMER_STOP  TCCR3B = 0                                         // Stop timer3 (flam)
#define FLAM_TIMER_START TCCR3B = _BV(WGM32) | _BV(CS31) | _BV(CS30);       // CTC mode & start timer with prescaler 64
#define FLAM_TIMER_ZERO  TCNT3  = 0                                         // reset timer (must be atomic)
byte triggerTime [NBR_INST];
byte cur_triggerTime;
#define PULSE 31;                                                           // # timer ticks for 2ms pulse @1024 prescaler
byte ledMap[NBR_INST] =
{16, 16, 8, 10, 11, 16, 15, 14, 0, 2, 4, 6, 16, 16, 12, 13};
unsigned int lastStepLeds = 0;
byte showTrigLeds = 0;
unsigned int gateLeds = 0;
unsigned int gateInst = 0;
