e-licktronic/Nava-v1.0/Nava_v1_028beta/Dio.ino

//-------------------------------------------------
//                  NAVA v1.x
//                  Dio utility
//-------------------------------------------------

/////////////////////Function//////////////////////
//Initialise IO PORT and libraries
void InitIO()
{
  DDRB = DDRB | B11011000;
  DDRD = DDRD | B11110000;
  DDRA = DDRA | B11101100;
  TRIG_HIGH;
  pinMode(DIN_START_PIN, OUTPUT);
  pinMode(DIN_CLK_PIN, OUTPUT);
  pinMode(TRIG1_PIN, OUTPUT);
  pinMode(TRIG2_PIN, OUTPUT);
  pinMode(ENC_PINA, INPUT);
  pinMode(ENC_PINB, INPUT);
  SPI.begin();
  SPI.usingInterrupt(255);
  Wire.begin();
}

//Scan DIN shift register with debounce time-------------------------------
void ScanDin()
{
  if ((millis() - debounceTimer) > DEBOUNCE_TIME)
  {
    debounceTimer = millis();
    //shiftregisted switches
    SPI.beginTransaction(SPIset_f); 
    SW_CS_HIGH;
    tempDin[0][0] = SPI.transfer(0);
    tempDin[1][0] = SPI.transfer(0);
    tempDin[2][0] = SPI.transfer(0);
    tempDin[3][0] = SPI.transfer(0);
    tempDin[4][0] = SPI.transfer(0);
    SW_CS_LOW;
    SPI.endTransaction();

    //µC direct pin switches
    encSwValue[0] = ENC_SW_GET;

    //Compare
    for (int a = 0; a < 5; a++){
      if (tempDin[a][0] == tempDin[a][1]) dinSr[a] = tempDin[a][0];
    }
    if (encSwValue[0] == encSwValue[1]) encSwState = encSwValue[0];
  }

  //shiftregisted switches
  SPI.beginTransaction(SPIset_f);
  SW_CS_HIGH;
  tempDin[0][1] = SPI.transfer(0);
  tempDin[1][1] = SPI.transfer(0);
  tempDin[2][1] = SPI.transfer(0);
  tempDin[3][1] = SPI.transfer(0);
  tempDin[4][1] = SPI.transfer(0);
  SW_CS_LOW; 
  SPI.endTransaction();

  //µC direct pin switches
  encSwValue[1] = ENC_SW_GET;
}

//Set Dout LED------------------------------------------------------------
void SetDoutLed(unsigned int stepLed, unsigned int configLed, byte menuLed)
{
  SPI.beginTransaction(SPIset_f);
  LED_CS_LOW;
  SPI.transfer(byte(stepLed >> 8));
  SPI.transfer(byte(stepLed));
  SPI.transfer(byte(configLed >>8));
  SPI.transfer(byte(configLed));
  SPI.transfer(byte(menuLed));
  LED_CS_HIGH;
  SPI.endTransaction(); 
}

//Set Dout Trig------------------------------------------------------------
void SetDoutTrig(unsigned int value)
{
  SPI.beginTransaction(SPIset_f);
  TRIG_CS_LOW;
  SPI.transfer(byte(value >> 8));
  SPI.transfer(byte(value));
  TRIG_CS_HIGH;
  SPI.endTransaction(); 
  lastDoutTrig = value;                                                           // [zabox] [1.027] save last trigger value
}

//Reset Dout Trig---------------------------------------------------------
void ResetDoutTrig()
{
  SPI.beginTransaction(SPIset_f);
  TRIG_CS_LOW;
  SPI.transfer(0);
  SPI.transfer(0);
  TRIG_CS_HIGH;
  SPI.endTransaction();
}

//Set Dac voltage---------------------------------------------------------
void SetDacA(byte velocity)
{
  
  //Serial.print(velocity);                                                      // test
  if (velocity >= 127) velocity = 127;
  //unsigned int milliVolt = map(velocity, 0, 127, 0, 4090);                   // [zabox] very slow
  unsigned int milliVolt = velocity << 5;                                  // [zabox] [1.028] fast. halves the mux execution time, but needs a 5v readjustment. (26mv/32mv offset at full velocity)
  unsigned int command = 0;
  command |= 0x1000;// Active DAC out A
  command |= (milliVolt & 0x0FFF);
  SPI.beginTransaction(SPIset_f);
  DAC_CS_LOW;
  SPI.transfer(command >> 8);
  SPI.transfer(command & 0xFF);
  DAC_CS_HIGH;
  SPI.endTransaction();
}

//Scan Din bootloader
void ScanDinBoot()
{
  SPI.beginTransaction(SPIset); 
  SW_CS_HIGH;
  SPI.transfer(0);
  SPI.transfer(0);
  btnPlayStopByte = SPI.transfer(0);
  SPI.transfer(0);
  btnEnterByte = SPI.transfer(0);
  SW_CS_LOW;
  SPI.endTransaction();
}


//Set the trig lenght value before reset trig out
void SetTrigPeriod(byte ms)
{ 
 
  static unsigned long trigPeriod;

  if (trigCounterStart){
    trigPeriod = millis();
    trigCounterStart = FALSE;
  }
  
  // [zabox] if the isr starts here in between, trigPeriod hasn't been updated and millis()-trigPeriod is still true < 10ms.  
  
  if ((millis() - trigPeriod >= ms) && !(PORTA & (1 << 2)) && trigCounterStart == FALSE) {              // [zabox] checking trigCounterStart == false fixes short trig out bug. 
    TRIG_HIGH;// Reset trigOut
  }

}
